JRegi/MagicAlonso-LineFollower/pcb/main_Magic_BluePIll/printable_PCB/Bluepillpinout.png

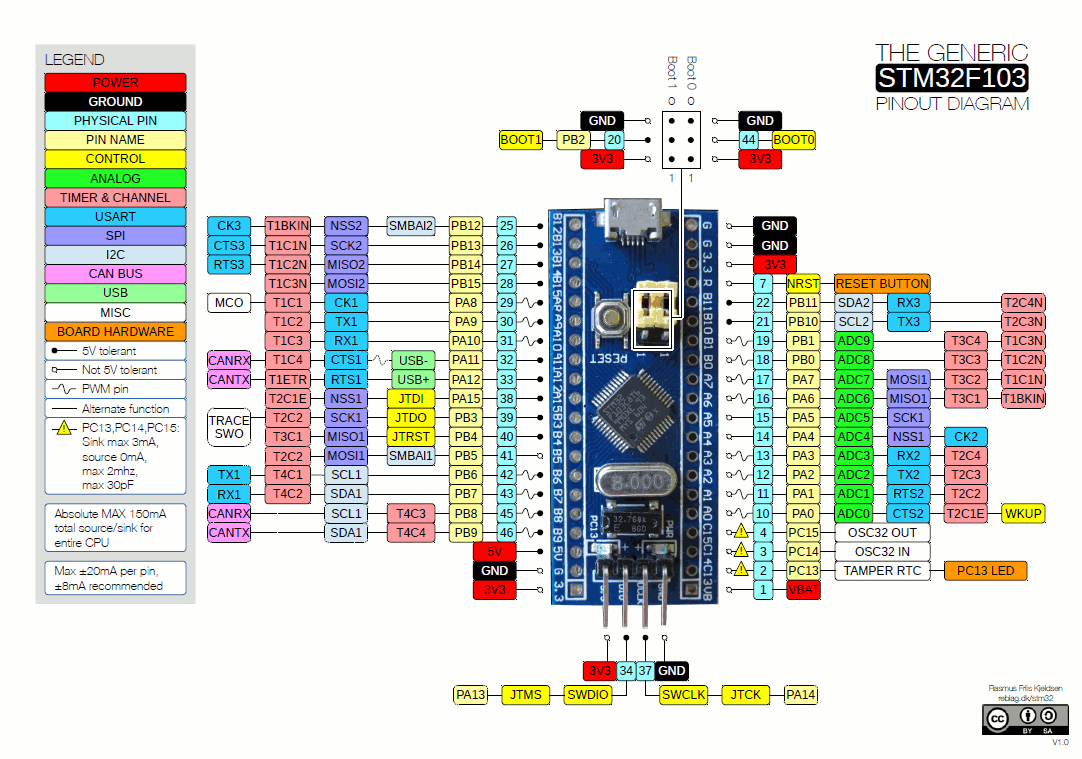
pcb/main_Magic_BluePIll/printable_PCB/Bluepillpinout.png
