JRegi/MagicAlonso-LineFollower/3D_Files/MagicAlonsoV1_ensamblado.jpg

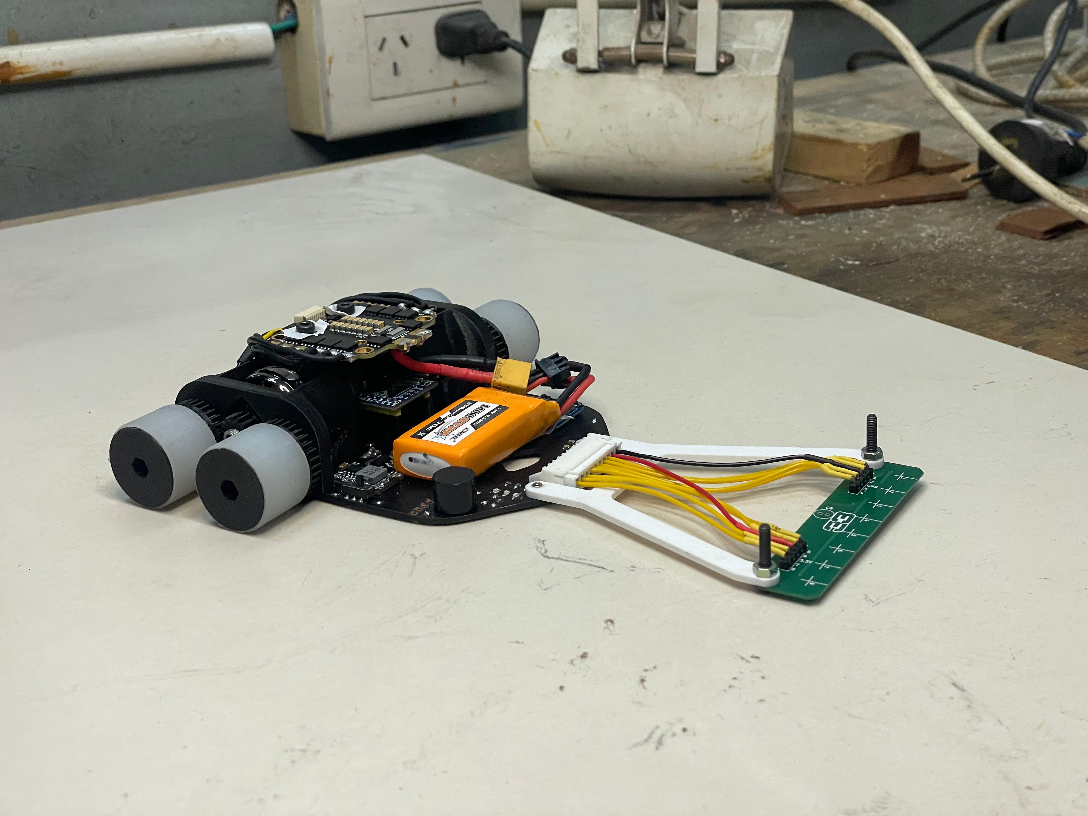
3D_Files/MagicAlonsoV1_ensamblado.jpg
