JRegi/MagicAlonso-LineFollower/README.md

# MagicAlonso - _Robot dedicado a la leyenda Asturiana del automobilismo_

## MagicAlonso V1 (sin turbina)

imagen

## Descripción

_MagicAlonso_ es un robot seguidor de líneas de alto rendimiento con tracción y succión brushless.
