JRegi/MagicAlonso-LineFollower/3D_Files/23.5mm Wheel version/Line_Sensors-Body.stl

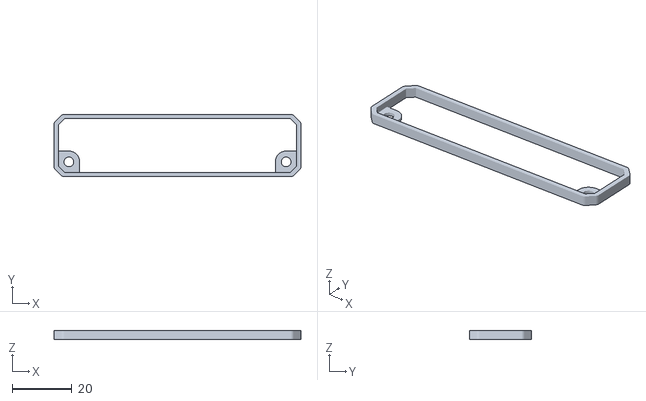
[picture p3: CAD file, 2025-08-07]
3D_Files/23.5mm Wheel version/Line_Sensors-Body.stl
83.0 x 21.0 x 3.00
