JRegi/MagicAlonso-LineFollower/3D_Files/step_files/pignon+12t+0.stp

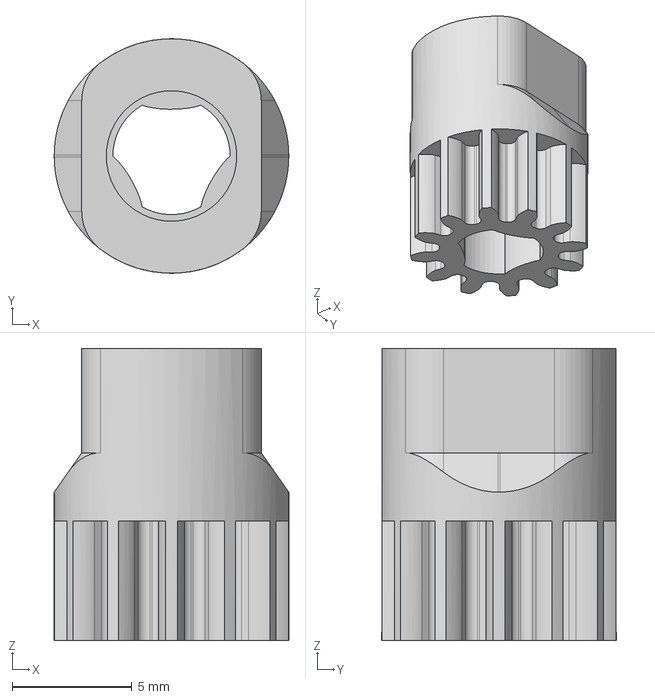
[picture p4: CAD file, 2025-07-22]
3D_Files/step_files/pignon+12t+0.stp
9.80 x 9.80 x 12.2 mm
