JRegi/MagicAlonso-LineFollower/pcb/Turbine_PCB_3P_Drawing.dxf

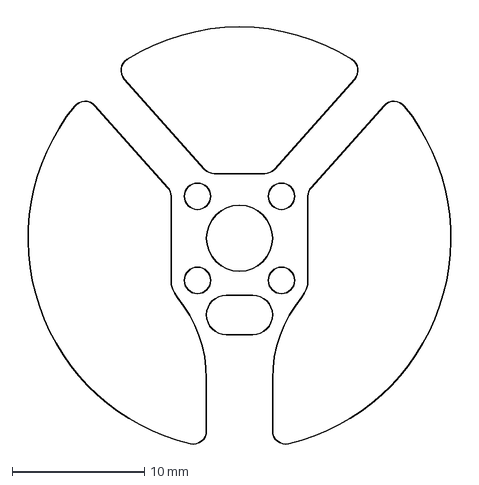
[picture p5: CAD file, 2025-08-18]
pcb/Turbine_PCB_3P_Drawing.dxf
33.8 x 32.4 mm
