JRegi/MagicAlonso-LineFollower/3D_Files/23.5mm Wheel version/Motor_mount.stl

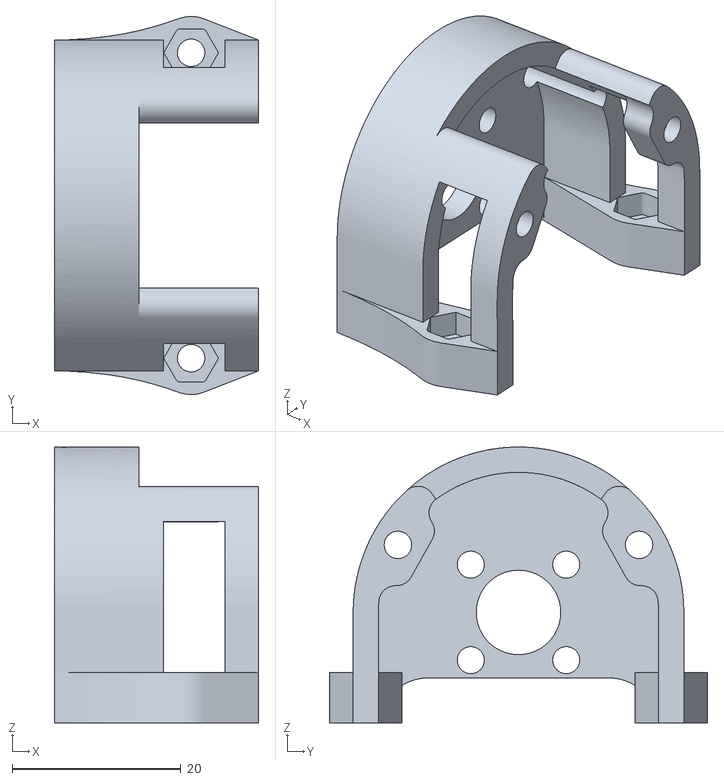
[picture p6: CAD file, 2025-07-22]
3D_Files/23.5mm Wheel version/Motor_mount.stl
24.2 x 44.8 x 32.7
