JRegi/MagicAlonso-LineFollower/3D_Files/Puente_V3.stl

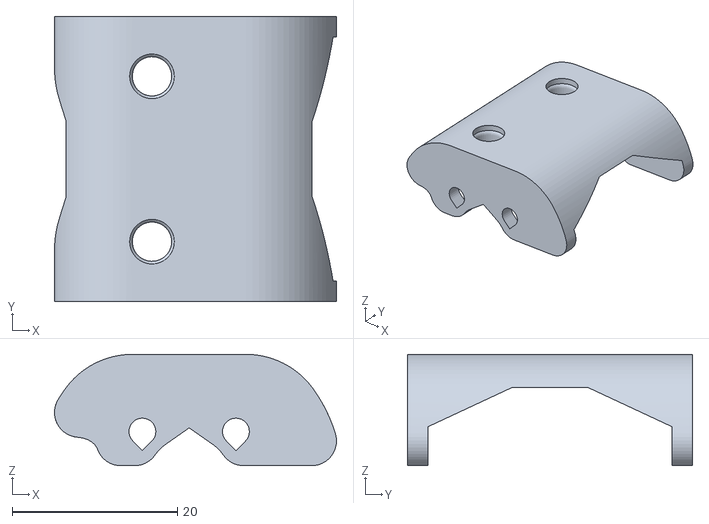
[picture p7: CAD file, 2025-09-01]
3D_Files/Puente_V3.stl
34.1 x 34.5 x 13.5
