JRegi/MagicAlonso-LineFollower/3D_Files/step_files/Molde+23.stp

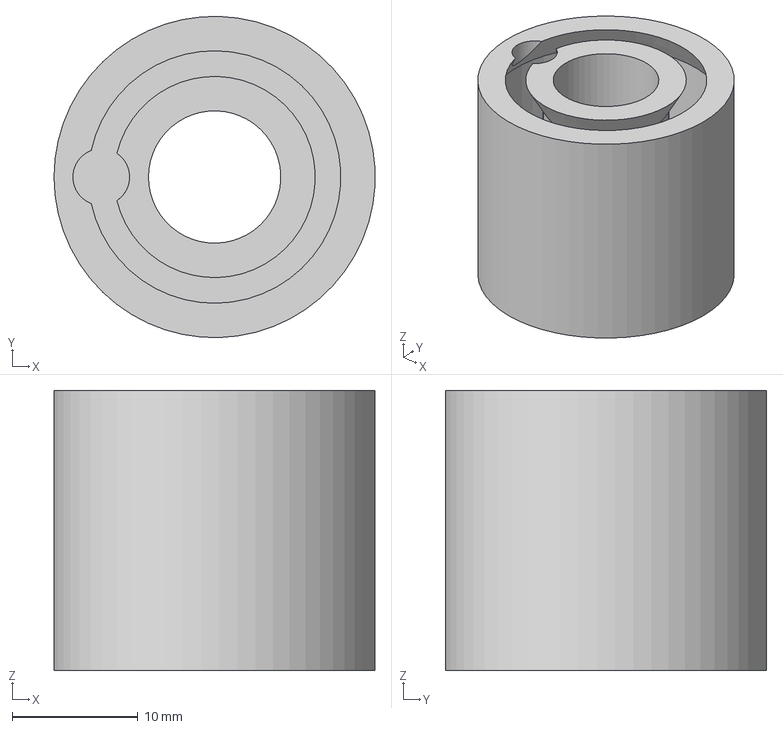
[picture p8: CAD file, 2025-07-22]
3D_Files/step_files/Molde+23.stp
25.5 x 25.5 x 22.2 mm
