JRegi/MagicAlonso-LineFollower/3D_Files/23.5mm Wheel version/23.5 Wheel 28 teeth v14.stl

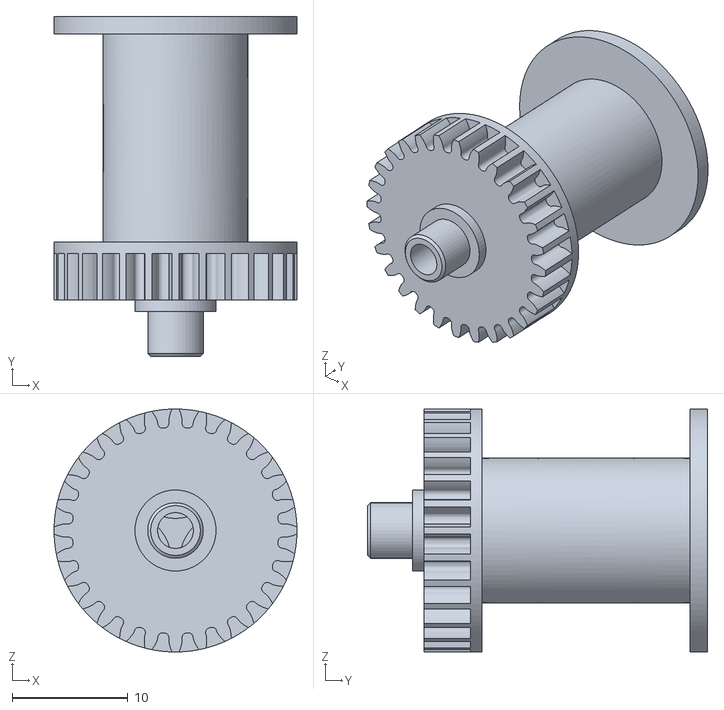
[picture p9: CAD file, 2025-06-03]
3D_Files/23.5mm Wheel version/23.5 Wheel 28 teeth v14.stl
21.0 x 29.4 x 21.0
