JRegi/MagicAlonso-LineFollower/3D_Files/Spur Gear (15 teeth).stl

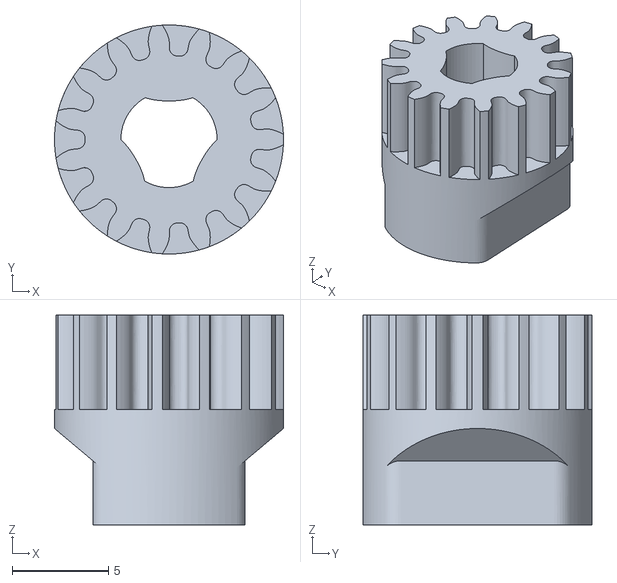
[picture p10: CAD file, 2025-09-01]
3D_Files/Spur Gear (15 teeth).stl
11.9 x 11.9 x 10.9
