JRegi/MagicAlonso-LineFollower/3D_Files/step_files/2.Redo2.9to1+23.stp

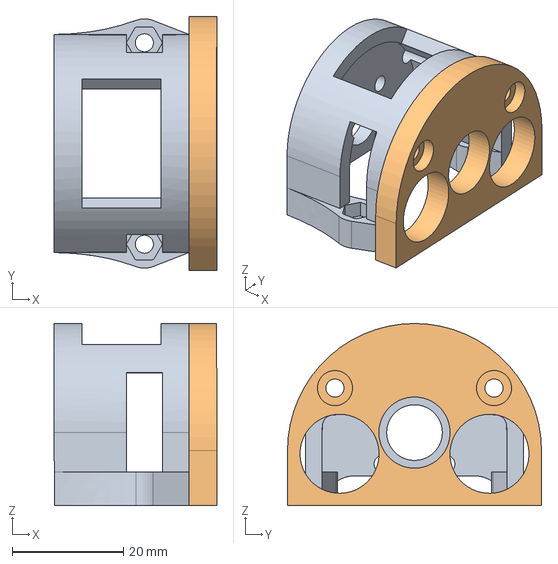
[picture p11: CAD file, 2025-07-22]
3D_Files/step_files/2.Redo2.9to1+23.stp
29.2 x 45.6 x 32.7 mm
Motor Mount
Wheel Mount
