JRegi/MagicAlonso-LineFollower/3D_Files/modulo_redu_V3.stl

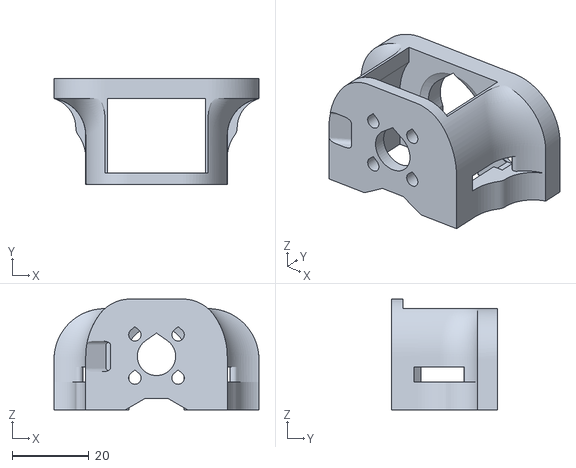
[picture p12: CAD file, 2025-09-01]
3D_Files/modulo_redu_V3.stl
53.6 x 27.8 x 29.0
