JRegi/MagicAlonso-LineFollower/3D_Files/step_files/23.stp

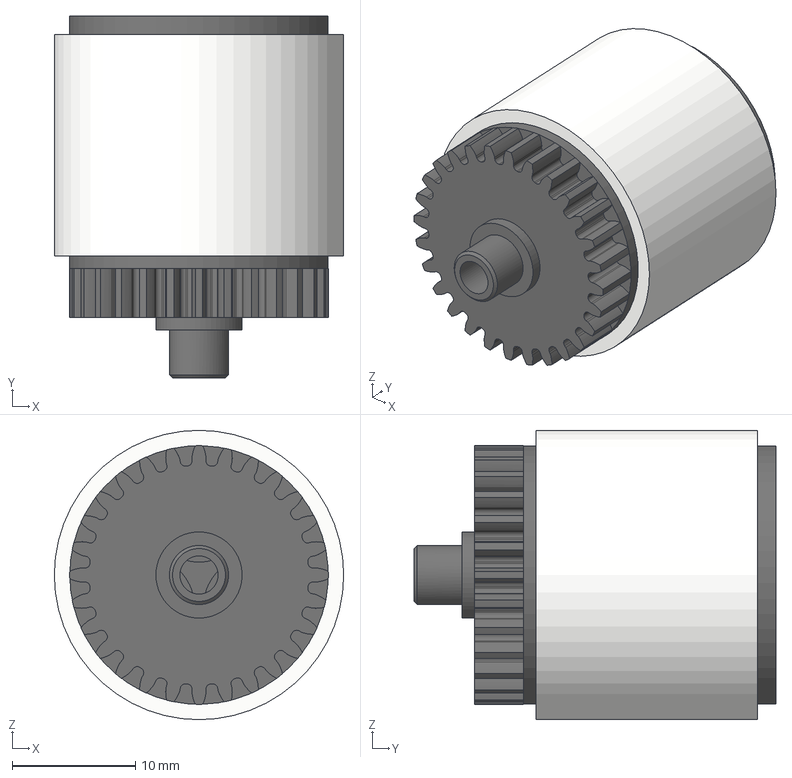
[picture p13: CAD file, 2025-07-22]
3D_Files/step_files/23.stp
23.5 x 29.4 x 23.5 mm
Rim
Spur Gear (28 teeth)
Tire
