JRegi/MagicAlonso-LineFollower/3D_Files/23.5mm Wheel version/Wheel Mount.stl

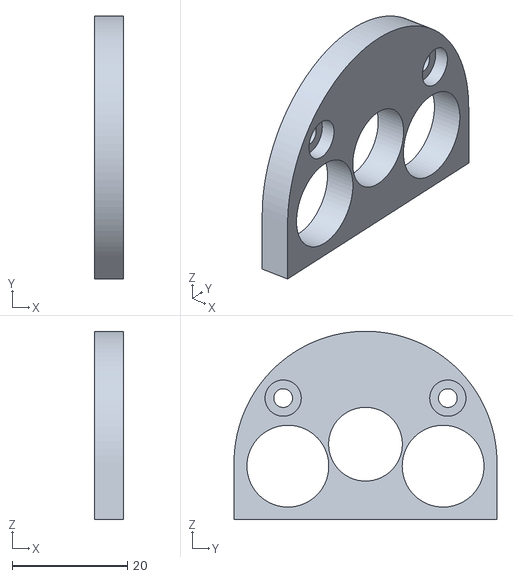
[picture p14: CAD file, 2025-06-03]
3D_Files/23.5mm Wheel version/Wheel Mount.stl
5.00 x 45.6 x 32.7
