JRegi/MagicAlonso-LineFollower/3D_Files/step_files/1.Redo2.stp

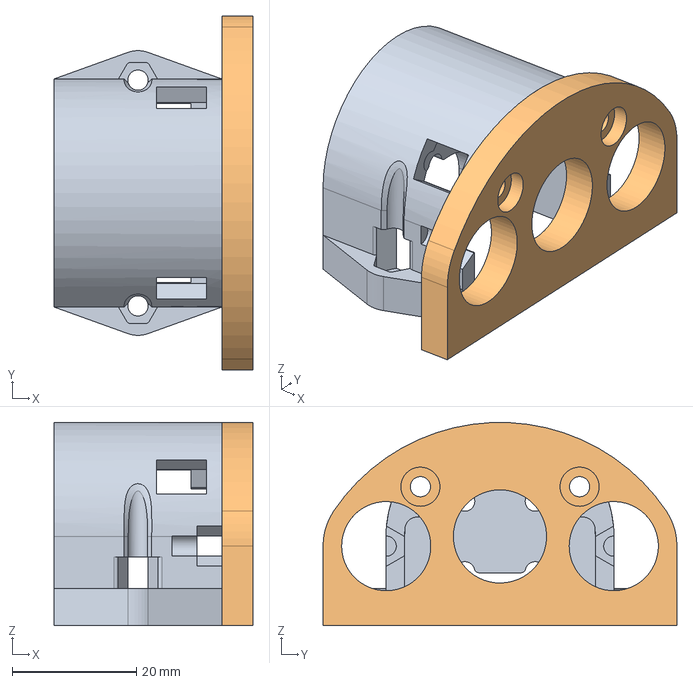
[picture p15: CAD file, 2025-07-22]
3D_Files/step_files/1.Redo2.stp
32.0 x 57.0 x 32.7 mm
Motor Mount
Wheel Mount
