JRegi/MagicAlonso-LineFollower/3D_Files/wheel_32teeth_26mm.stl

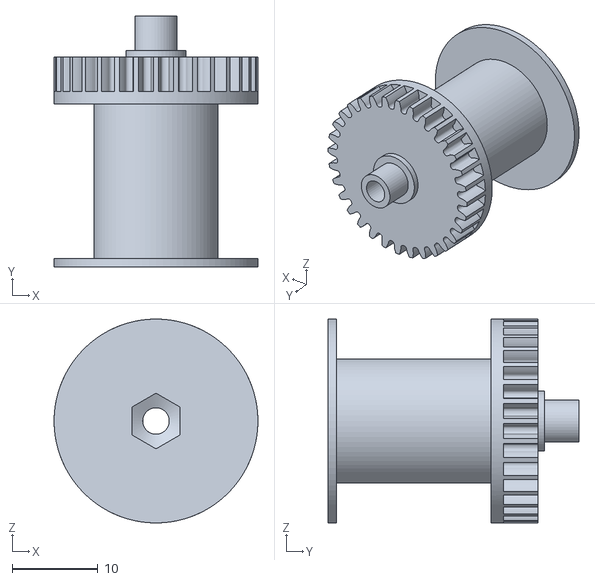
[picture p16: CAD file, 2025-09-01]
3D_Files/wheel_32teeth_26mm.stl
23.8 x 29.3 x 23.8
