JRegi/MagicAlonso-LineFollower/3D_Files/turbine_PCB_Drawing.dxf

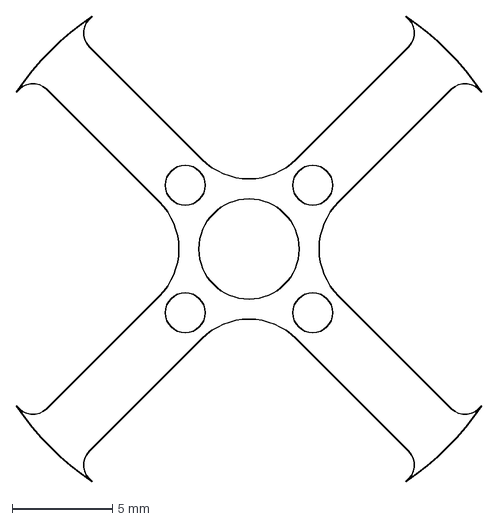
[picture p17: CAD file, 2025-08-06]
3D_Files/turbine_PCB_Drawing.dxf
23.2 x 23.2 mm
