JRegi/MagicAlonso-LineFollower/(list of files, cad)

Other CAD files:
3D_Files/1404_redu_footprint.dxf
3D_Files/23.5mm Wheel version/pignon 12t 0.7 short.stl
3D_Files/step_files/reduction.FCStd
