JRegi/MagicAlonso-LineFollower/pcb/main_Magic_BluePIll/printable_pcb.pdf

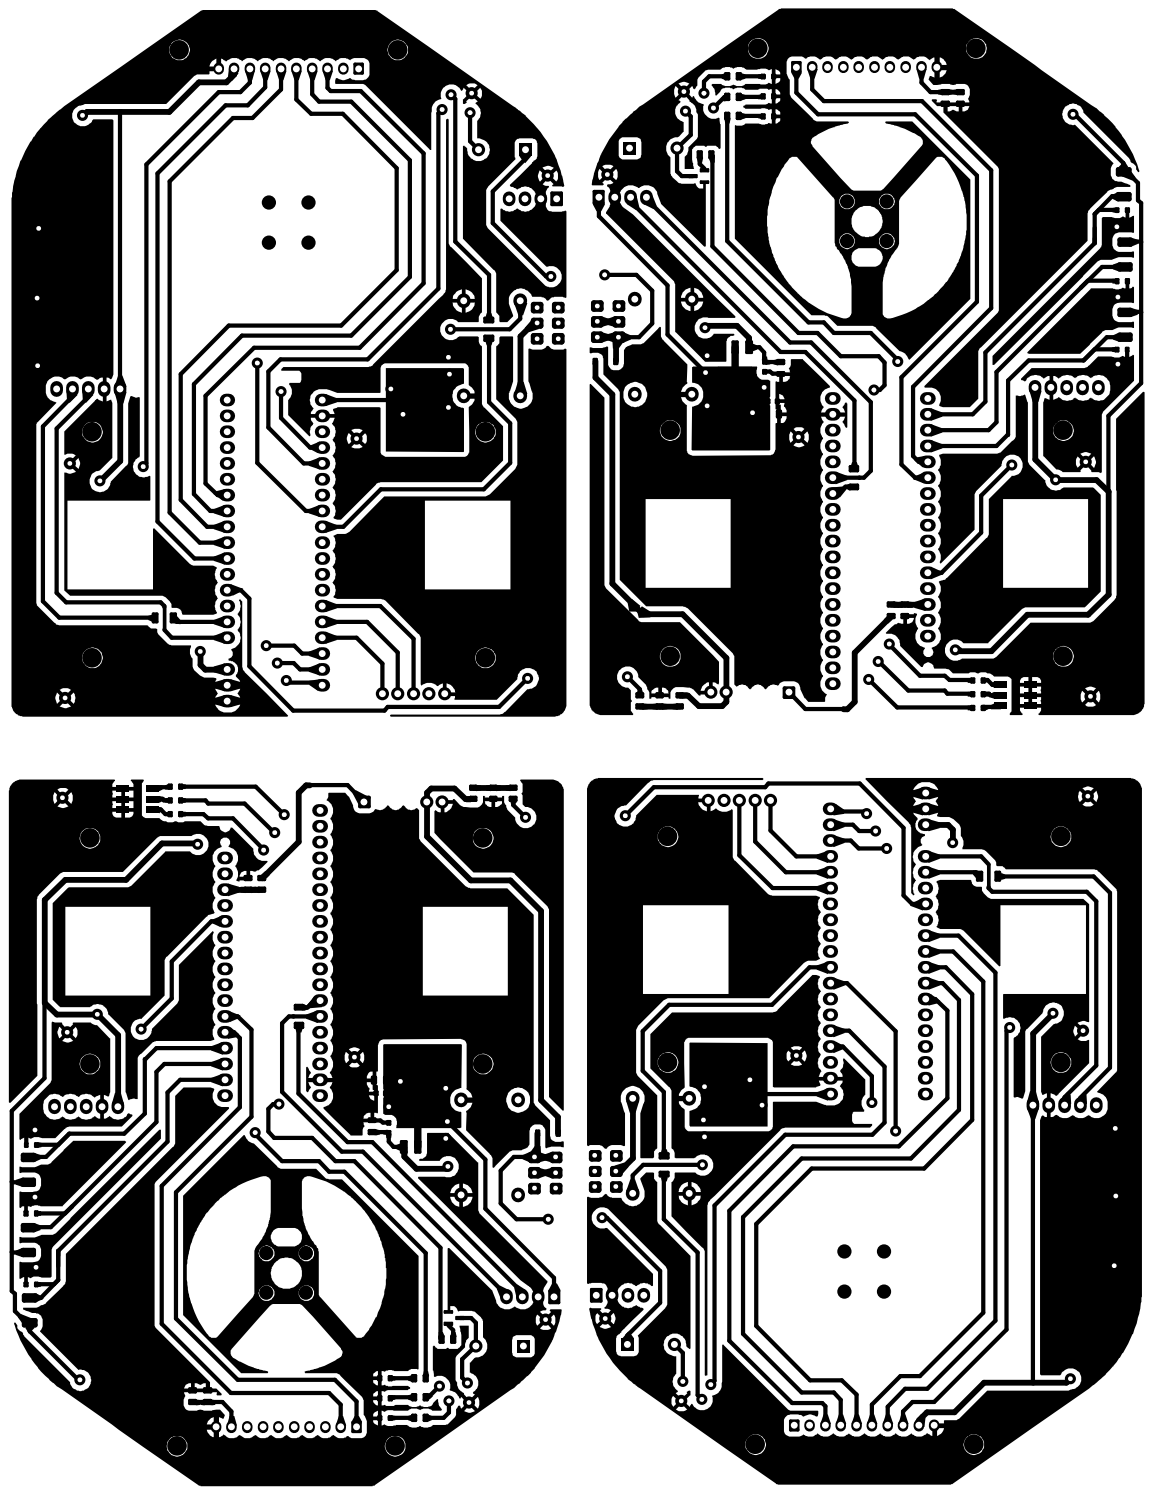
[picture p18: page 1]
