JRegi/MagicAlonso-LineFollower/pcb/ESP32_main_boards/main_Magic-simple/printable-pcb/main_Magic-simple_printable.pdf

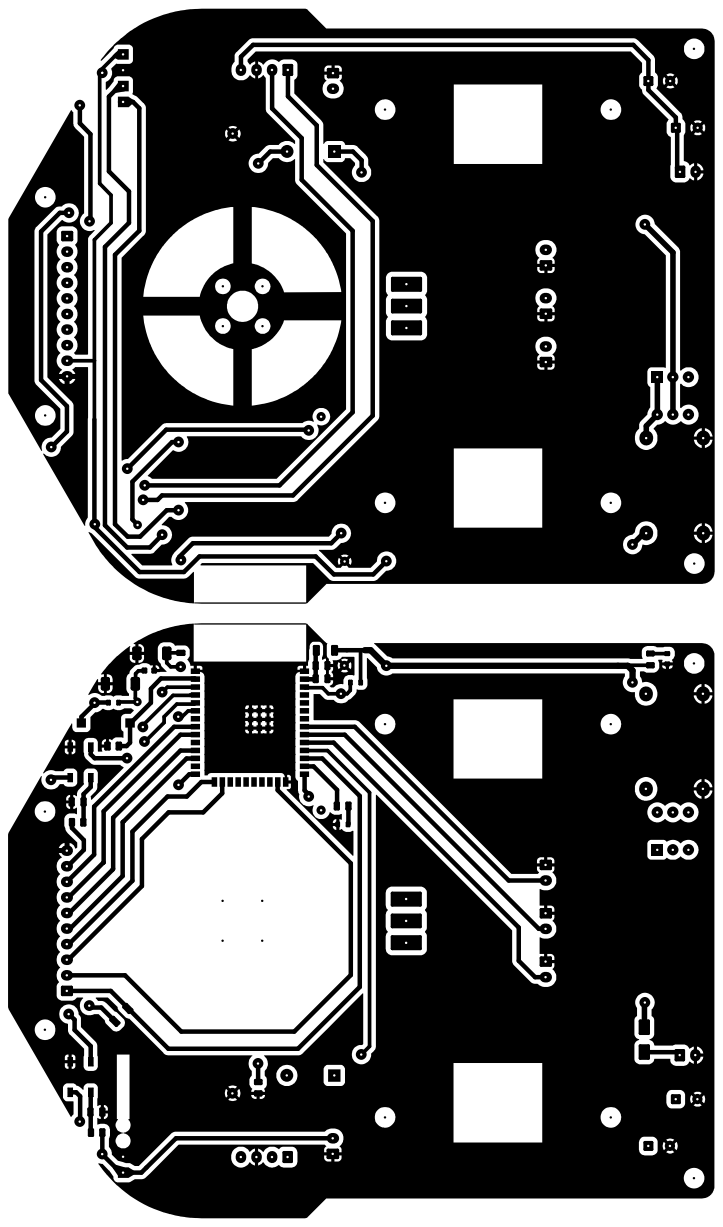
[picture p19: page 1]
