JRegi/MagicAlonso-LineFollower/pcb/main_Magic_BluePIll/main_BluePIll_1st_archive/main_Magic_BluePIll.kicad_pcb

## KiCad design pcb/main_Magic_BluePIll/main_BluePIll_1st_archive/main_Magic_BluePIll.kicad_pcb (2025-08-18, an earlier design)

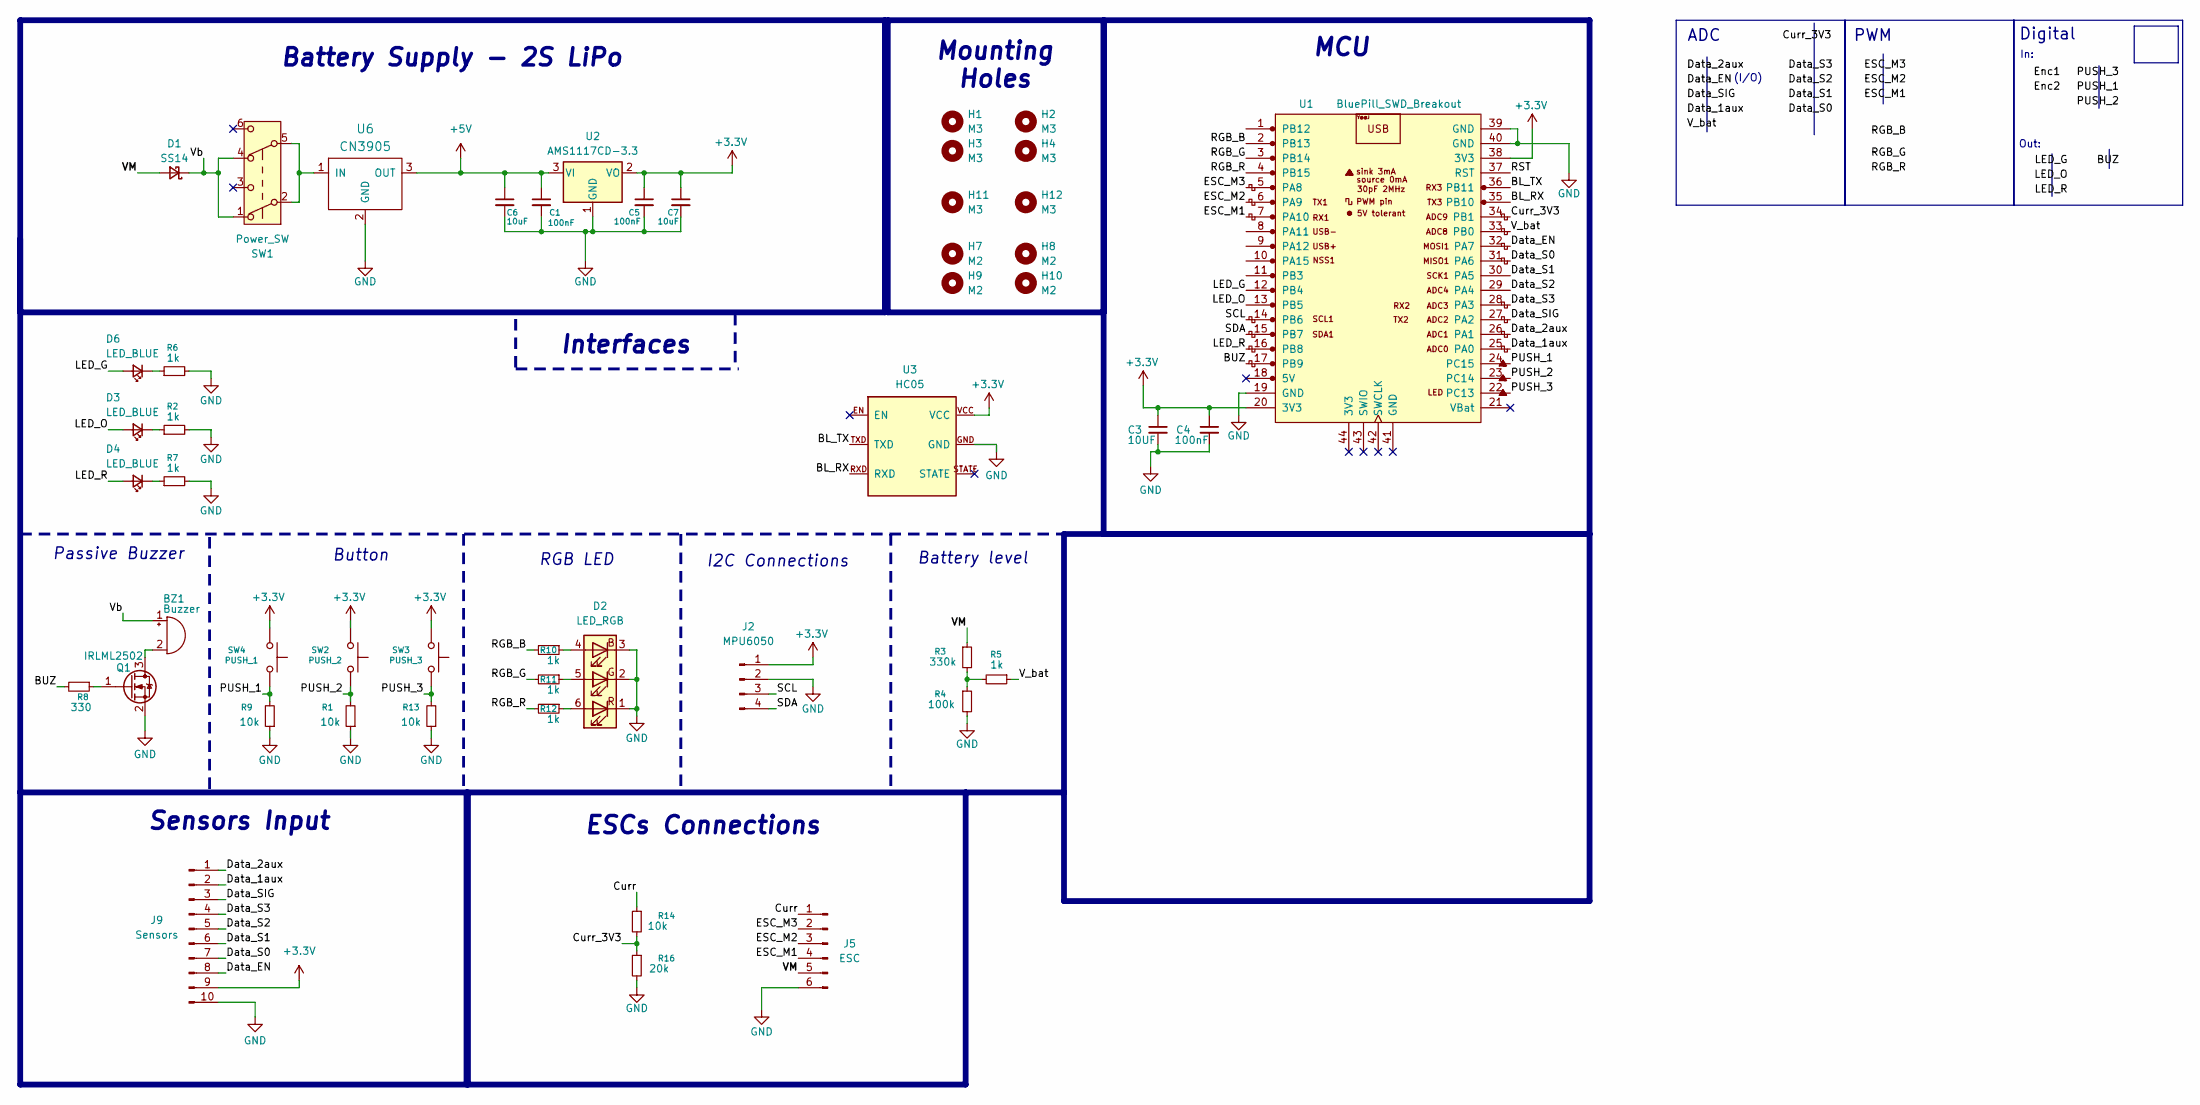
[picture p20: schematic main_Magic_BluePIll.kicad_sch, MagicAlonso main control PCB]

Parts:
BZ1: Buzzer; Buzzer_12x9.5RM7.6
C1, C5: 100nF; C_0603_1608Metric
C3: 10UF; C_0805_2012Metric
C4: 100nF; C_0805_2012Metric
C6, C7: 10uF; C_0805_2012Metric
D1: SS14; D_SOD-123
D2: LED_RGB; LED_RGB_5050-6
D3, D4, D6: LED_BLUE; LED_0805_2012Metric
H1, H2, H3, H4, H11, H12: M3; MountingHole_3mm
H7, H8, H9, H10: M2; MountingHole_2.2mm_M2
J2: MPU6050; MPU6050_Module
J5: ESC; JST_XH_B6B-XH-A_1x06_P2.50mm_Vertical
J9: Sensors; JST_XH_S10B-XH-A_1x10_P2.50mm_Horizontal
Q1: IRLML2502; SOT-23
R1, R9, R13: 10k; R_0603_1608Metric
R2, R6, R7, R10, R11, R12: 1k; R_0603_1608Metric
R3: 330k; R_0805_2012Metric
R4: 100k; R_0805_2012Metric
R5: 1k; R_0805_2012Metric
R8: 330; R_0805_2012Metric
R14: 10k; R_0805_2012Metric
R16: 20k; R_0805_2012Metric
SW1: Power_SW; SW_DPDT_SLIDE_THT
SW2: PUSH_2; SW_Push_Sw-3424p_Handsolder
SW3: PUSH_3; SW_Push_Sw-3424p_Handsolder
SW4: PUSH_1; SW_Push_Sw-3424p_Handsolder
U1: BluePill_SWD_Breakout; BluePill
U2: AMS1117CD-3.3; TO-252-3_TabPin2
U3: HC05
U6: CN3905; Mini360_step-down

Connections:
+3.3V: C3.1, C4.1, C5.1, C7.1, J2.1, J9.9, SW2.1, SW3.1, SW4.1, U1.20 (3V3), U1.38 (3V3), U2.2 (VO), U3.VCC
+5V: C1.1, C6.1, U2.3 (VI), U6.3 (OUT)
/BL_RX: U1.35 (PB10), U3.RXD
/BL_TX: U1.36 (PB11), U3.TXD
/BUZ: R8.2, U1.17 (PB9)
/Curr: J5.1, R14.1
/Curr_3V3: R14.2, R16.1, U1.34 (PB1)
/Data_1aux: J9.2, U1.25 (PA0)
/Data_2aux: J9.1, U1.26 (PA1)
/Data_EN: J9.8, U1.32 (PA7)
/Data_S0: J9.7, U1.31 (PA6)
/Data_S1: J9.6, U1.30 (PA5)
/Data_S2: J9.5, U1.29 (PA4)
/Data_S3: J9.4, U1.28 (PA3)
/Data_SIG: J9.3, U1.27 (PA2)
/ESC_M1: J5.4, U1.7 (PA10)
/ESC_M2: J5.3, U1.6 (PA9)
/ESC_M3: J5.2, U1.5 (PA8)
/LED_G: D6.2 (A), U1.12 (PB4)
/LED_O: D3.2 (A), U1.13 (PB5)
/LED_R: D4.2 (A), U1.16 (PB8)
/PUSH_1: R9.2, SW4.2, U1.24 (PC15)
/PUSH_2: R1.2, SW2.2, U1.23 (PC14)
/PUSH_3: R13.2, SW3.2, U1.22 (PC13)
/RGB_B: R10.2, U1.2 (PB13)
/RGB_G: R11.2, U1.3 (PB14)
/RGB_R: R12.2, U1.4 (PB15)
/RST: U1.37 (RST)
/SCL: J2.3, U1.14 (PB6)
/SDA: J2.4, U1.15 (PB7)
/VM: D1.2 (A), J5.5, R3.1
/V_bat: R5.1, U1.33 (PB0)
/Vb: BZ1.1 (+), D1.1 (K), SW1.1 (A), SW1.4 (A)
GND: C1.2, C3.2, C4.2, C5.2, C6.2, C7.2, D2.1 (RK), D2.2 (GK), D2.3 (BK), J2.2, J5.6, J9.10, Q1.2 (S), R1.1, R2.2, R4.2, R6.2, R7.2, R9.1, R13.1, R16.2, U1.19 (GND), U1.39 (GND), U1.40 (GND), U2.1 (GND), U3.GND, U6.2 (GND)
unnamed: BZ1.2 (-), Q1.3 (D)
unnamed: D2.4 (BA), R10.1
unnamed: D2.5 (GA), R11.1
unnamed: D2.6 (RA), R12.1
unnamed: D3.1 (K), R2.1
unnamed: D4.1 (K), R7.1
unnamed: D6.1 (K), R6.1
unnamed: Q1.1 (G), R8.1
unnamed: R3.2, R4.1, R5.2
unnamed: SW1.2 (B), SW1.5 (B), U6.1 (IN)

Notes on the sheet:
Out:
(I/O)
Passive Buzzer
Digital
Battery level
I2C Connections
Mounting Holes
Battery Supply - 2S LiPo
In:
Sensors Input
MCU
ESCs Connections
PWM
RGB LED
Button
Interfaces
ADC

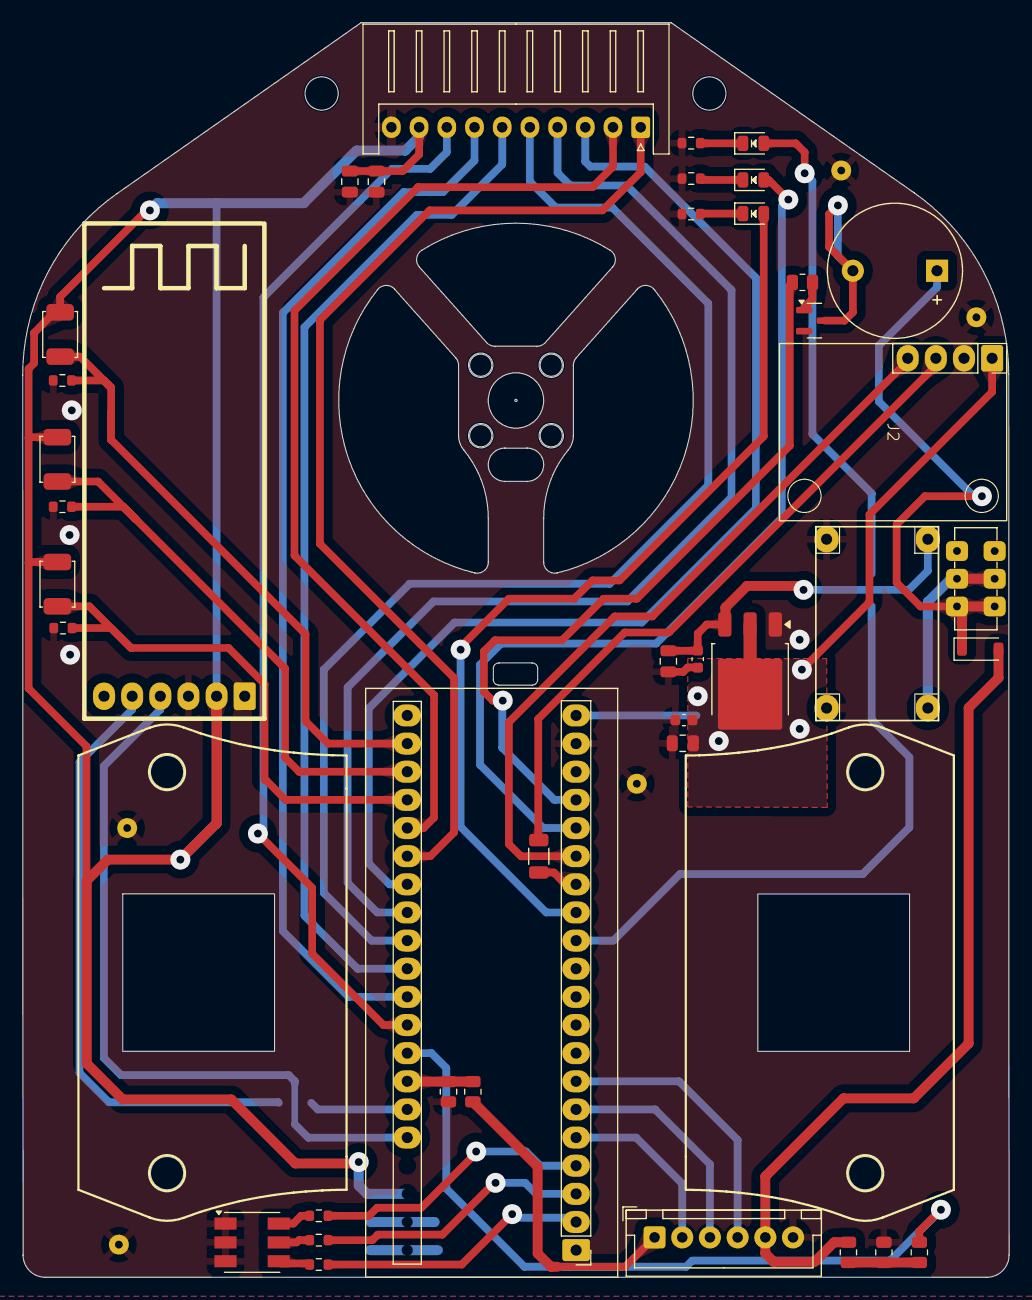
[picture p21: board main_Magic_BluePIll.kicad_pcb from above]

Board: 2 copper layers, 89.0 x 113.2 mm, 49 parts (0 on the bottom side), 43 nets.
