JRegi/MagicAlonso-LineFollower/pcb/ESP32_main_boards/main_Magic-simple/main_Magic-simple.kicad_pcb

## KiCad design pcb/ESP32_main_boards/main_Magic-simple/main_Magic-simple.kicad_pcb (2025-08-06)

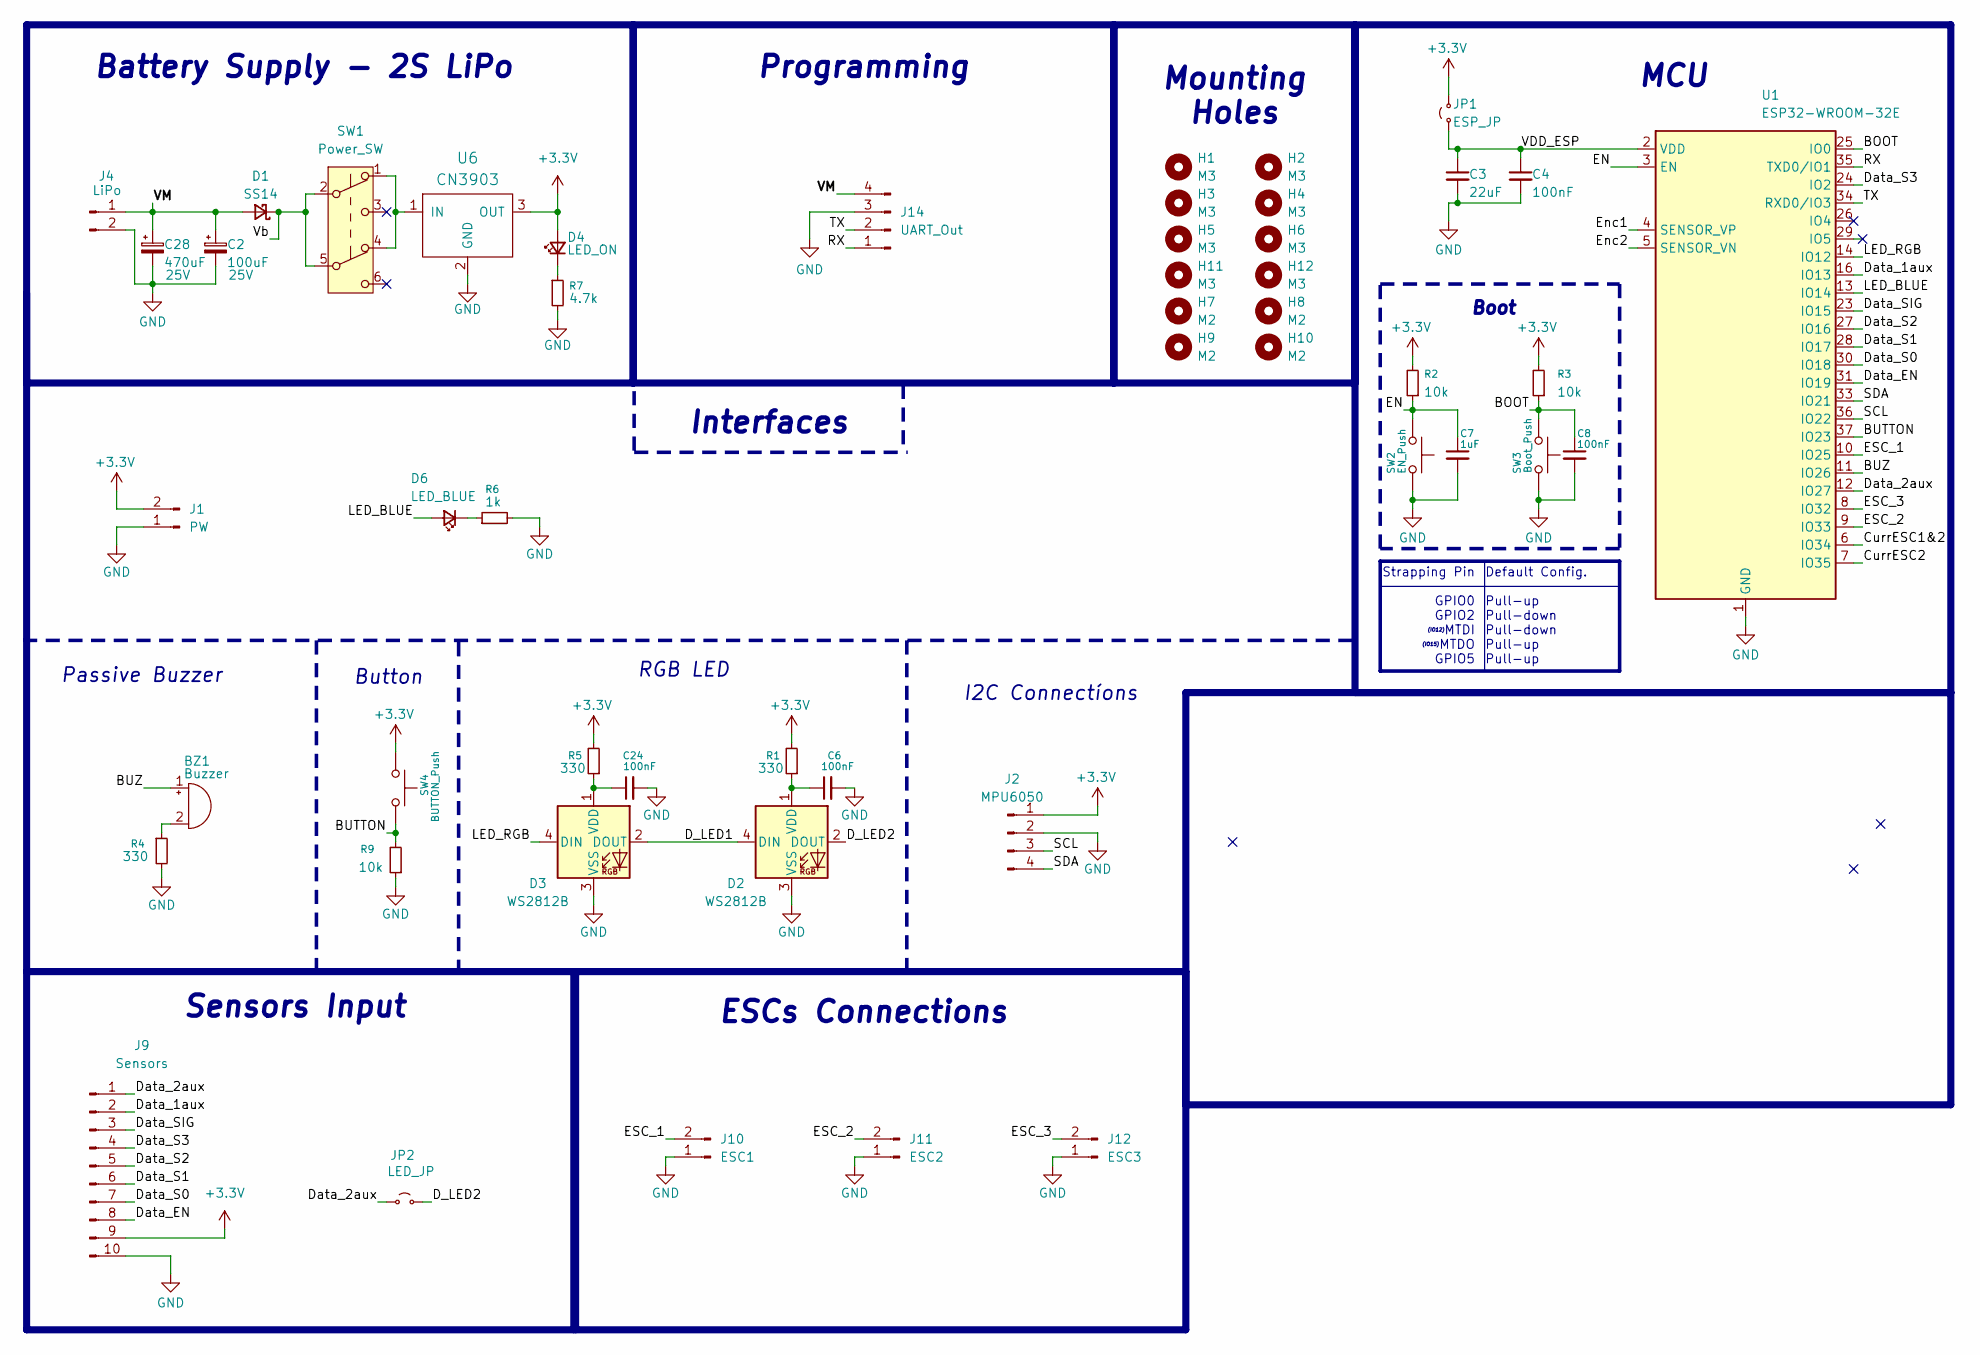
[picture p22: schematic main_Magic-simple.kicad_sch, MagicAlonso main control PCB]

Parts:
BZ1: Buzzer; Buzzer_12x9.5RM7.6
C2: 100uF; CP_Radial_D8.0mm_P3.50mm
C3: 22uF; C_0805_2012Metric
C4, C6, C24: 100nF; C_0805_2012Metric
C7: 1uF; C_0805_2012Metric
C8: 100nF; C_0603_1608Metric
C28: 470uF; CP_Radial_D8.0mm_P3.50mm
D1: SS14; D_SMA
D2, D3: WS2812B; LED_WS2812B_PLCC4_5.0x5.0mm_P3.2mm
D4: LED_ON; LED_0805_2012Metric
D6: LED_BLUE; LED_0805_2012Metric
H1, H2, H3, H4, H5, H6, H11, H12: M3; MountingHole_3mm
H7, H8, H9, H10: M2; MountingHole_2.2mm_M2
J1: PW; JST_XH_B2B-XH-A_1x02_P2.50mm_Vertical
J2: MPU6050; MPU6050_Module
J4: LiPo; JST_XH_S2B-XH-A_1x02_P2.50mm_Horizontal
J9: Sensors; JST_XH_S10B-XH-A_1x10_P2.50mm_Horizontal
J10: ESC1; JST_XH_S2B-XH-A_1x02_P2.50mm_Horizontal
J11: ESC2; JST_XH_S2B-XH-A_1x02_P2.50mm_Horizontal
J12: ESC3; JST_XH_S2B-XH-A_1x02_P2.50mm_Horizontal
J14: UART_Out; JST_XH_S4B-XH-A_1x04_P2.50mm_Horizontal
JP1: ESP_JP; R_1206_3216Metric
JP2: LED_JP; R_1206_3216Metric
R1, R4, R5: 330; R_0805_2012Metric
R2, R3: 10k; R_0603_1608Metric
R6: 1k; R_0603_1608Metric
R7: 4.7k; R_0603_1608Metric
R9: 10k; R_0805_2012Metric
SW1: Power_SW; SW_Push_2P2T_Toggle_CK_PVA2OAH5xxxxxxV2
SW2: EN_Push; SW_Push_SPST_NO_Alps_SKRK_Handsolder
SW3: Boot_Push; SW_Push_SPST_NO_Alps_SKRK_Handsolder
SW4: BUTTON_Push; SW_SPST_CK_RS282G05A3
U1: ESP32-WROOM-32E
U6: CN3903; Mini360_step-down

Connections:
+3.3V: D4.2 (A), J1.2, J2.1, J9.9, JP1.2 (B), R1.2, R2.2, R3.2, R5.2, SW4.1, U6.3 (OUT)
/BOOT: C8.1, R3.1, SW3.1, U1.25 (IO0)
/BUTTON: R9.2, SW4.2, U1.37 (IO23)
/BUZ: BZ1.1 (+), U1.11 (IO26)
/CurrESC1&2: U1.6 (IO34)
/CurrESC2: U1.7 (IO35)
/D_LED1: D2.4 (DIN), D3.2 (DOUT)
/D_LED2: D2.2 (DOUT), JP2.2 (B)
/Data_1aux: J9.2, U1.16 (IO13)
/Data_2aux: J9.1, JP2.1 (A), U1.12 (IO27)
/Data_EN: J9.8, U1.31 (IO19)
/Data_S0: J9.7, U1.30 (IO18)
/Data_S1: J9.6, U1.28 (IO17)
/Data_S2: J9.5, U1.27 (IO16)
/Data_S3: J9.4, U1.24 (IO2)
/Data_SIG: J9.3, U1.23 (IO15)
/EN: C7.1, R2.1, SW2.1, U1.3 (EN)
/ESC_1: J10.2, U1.10 (IO25)
/ESC_2: J11.2, U1.9 (IO33)
/ESC_3: J12.2, U1.8 (IO32)
/Enc1: U1.4 (SENSOR_VP)
/Enc2: U1.5 (SENSOR_VN)
/LED_BLUE: D6.2 (A), U1.13 (IO14)
/LED_RGB: D3.4 (DIN), U1.14 (IO12)
/RX: J14.1, U1.35 (TXD0/IO1)
/SCL: J2.3, U1.36 (IO22)
/SDA: J2.4, U1.33 (IO21)
/TX: J14.2, U1.34 (RXD0/IO3)
/VDD_ESP: C3.1, C4.1, JP1.1 (A), U1.2 (VDD)
/VM: C2.1, C28.1, D1.2 (A), J4.1, J14.4
/Vb: D1.1 (K), SW1.2 (B), SW1.5 (B)
GND: C2.2, C3.2, C4.2, C6.2, C7.2, C8.2, C24.2, C28.2, D2.3 (VSS), D3.3 (VSS), J1.1, J2.2, J4.2, J9.10, J10.1, J11.1, J12.1, J14.3, R4.2, R6.2, R7.2, R9.1, SW2.2, SW3.2, U1.1 (GND), U1.15 (GND), U1.38 (GND), U1.39 (GND), U6.2 (GND)
unnamed: BZ1.2 (-), R4.1
unnamed: C6.1, D2.1 (VDD), R1.1
unnamed: C24.1, D3.1 (VDD), R5.1
unnamed: D4.1 (K), R7.1
unnamed: D6.1 (K), R6.1
unnamed: SW1.1 (A), SW1.4 (A), U6.1 (IN)

Notes on the sheet:
Strapping Pin GPIO0 GPIO2 MTDI MTDO GPIO5
(IO12)
Passive Buzzer
(IO15)
I2C Connectíons
Mounting Holes
Battery Supply - 2S LiPo
Sensors Input
MCU
ESCs Connections
Boot
RGB LED
Button
Interfaces
Default Config. Pull-up Pull-down Pull-down Pull-up Pull-up
Programming

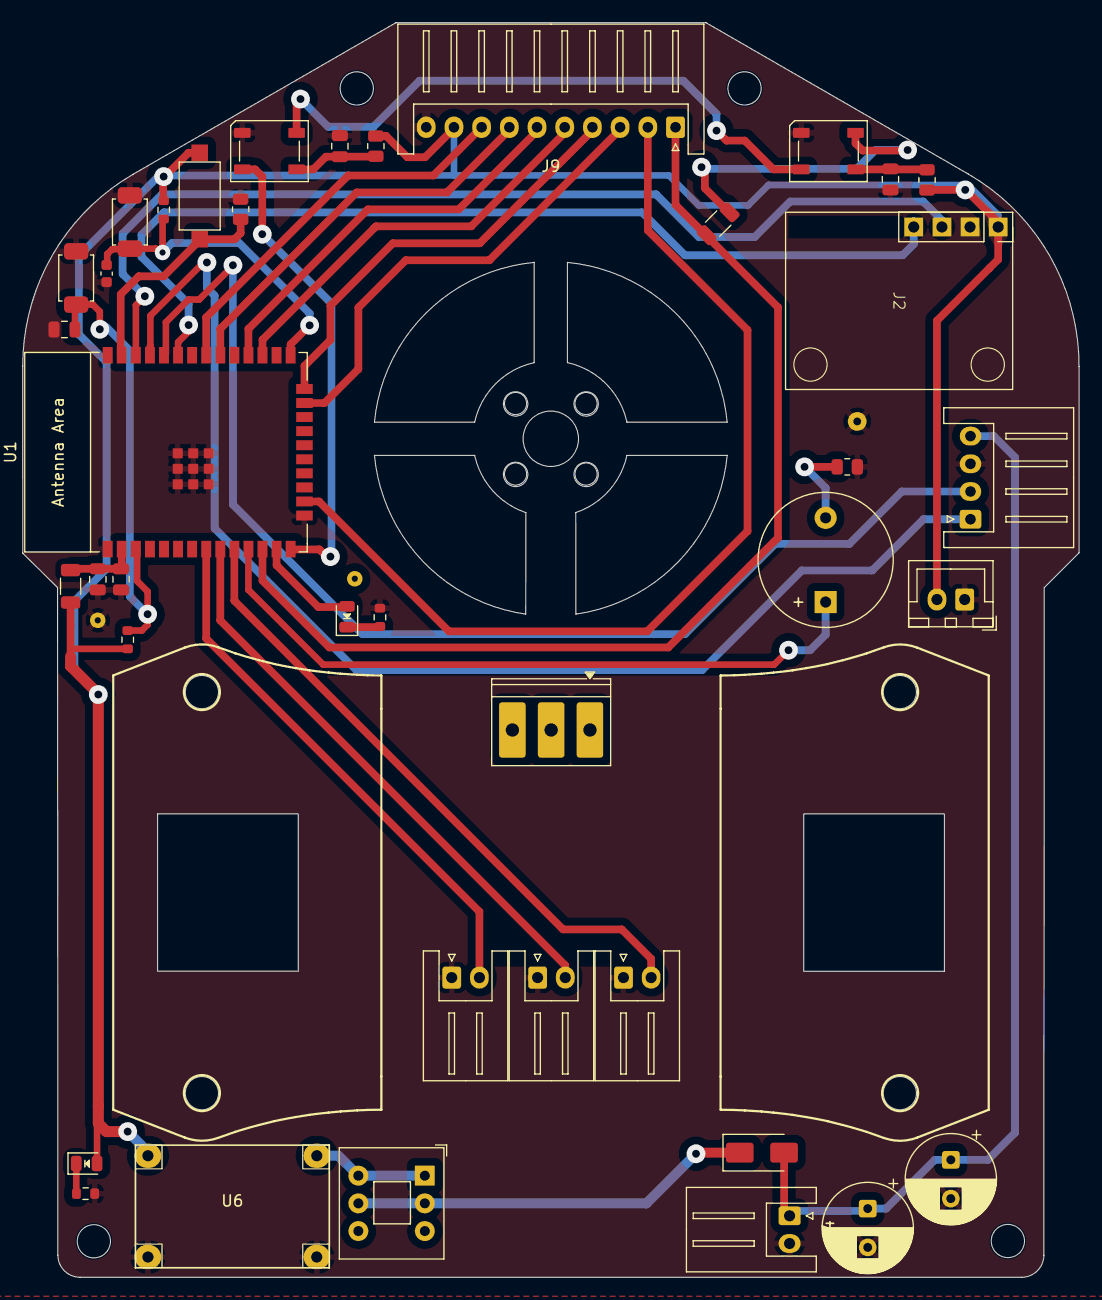
[picture p23: board main_Magic-simple.kicad_pcb from above]

Board: 2 copper layers, 95.3 x 113.2 mm, 51 parts (0 on the bottom side), 34 nets.

Other parts of the board:
ESC_3: TerminalBlock_Phoenix_PT-1,5-3-3.5-H_1x03_P3.50mm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; TerminalBlock_Phoenix_PT-1,5-3-3.5-H_1x03_P3.50mm_Horizontal
