JRegi/MagicAlonso-LineFollower/pcb/ESP32_main_boards/main_MagicAlonso/main_MagicAlonso.kicad_pcb

## KiCad design pcb/ESP32_main_boards/main_MagicAlonso/main_MagicAlonso.kicad_pcb (2025-08-06)

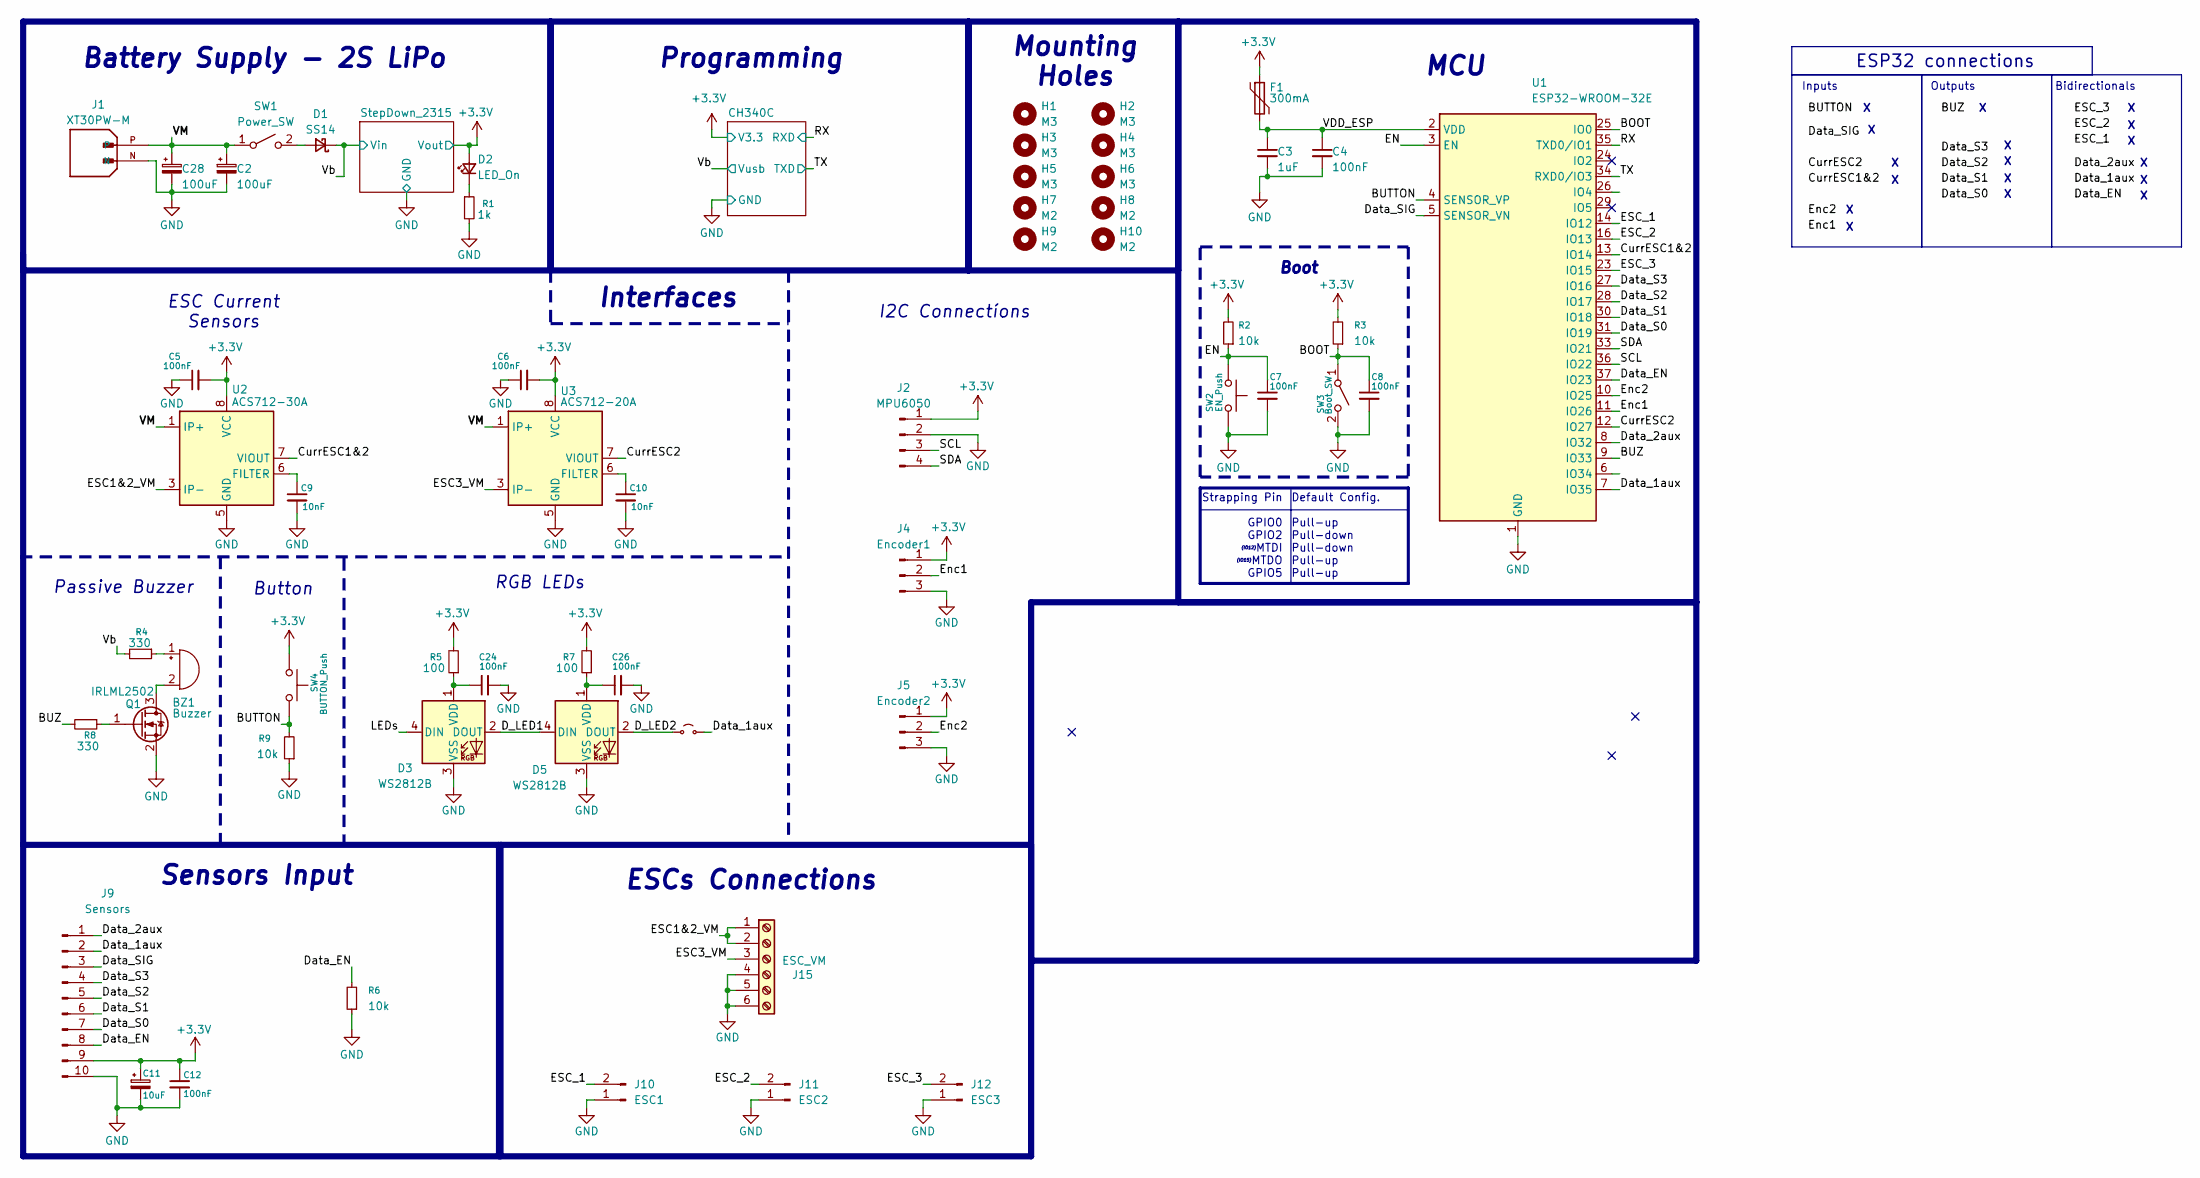
[picture p24: schematic main_MagicAlonso.kicad_sch, MagicAlonso main control PCB]

Parts:
BZ1: Buzzer; Buzzer_12x9.5RM7.6
C2, C28: 100uF; CP_Elec_6.3x5.4
C3: 1uF; C_0805_2012Metric
C4, C7, C12, C24, C26: 100nF; C_0805_2012Metric
C5, C6, C8: 100nF; C_0603_1608Metric
C9, C10: 10nF; C_0805_2012Metric
C11: 10uF; C_0805_2012Metric
D1: SS14; D_SMA
D2: LED_On; LED_0805_2012Metric
D3, D5: WS2812B; LED_WS2812B_PLCC4_5.0x5.0mm_P3.2mm
F1: 300mA; Fuse_1812_4532Metric_Pad1.30x3.40mm_HandSolder
H1, H2, H3, H4, H5, H6: M3; MountingHole_3mm
H7, H8, H9, H10: M2; MountingHole_2.2mm_M2
J1: XT30PW-M; AMASS_XT30PW-M; PARTREV 1.2
J2: MPU6050; MPU6050_Module
J4: Encoder1; JST_XH_B3B-XH-A_1x03_P2.50mm_Vertical
J5: Encoder2; JST_XH_B3B-XH-A_1x03_P2.50mm_Vertical
J9: Sensors; JST_XH_S10B-XH-A_1x10_P2.50mm_Horizontal
J10: ESC1; JST_XH_S2B-XH-A_1x02_P2.50mm_Horizontal
J11: ESC2; JST_XH_S2B-XH-A_1x02_P2.50mm_Horizontal
J12: ESC3; JST_XH_S2B-XH-A_1x02_P2.50mm_Horizontal
J15: ESC_VM; TerminalBlock_Phoenix_PT-1,5-6-3.5-H_1x06_P3.50mm_Horizontal
JP1: Jumper_2_Small_Open; R_1206_3216Metric
Q1: IRLML2502; SOT-23
R1: 1k; R_0603_1608Metric
R2, R3: 10k; R_0603_1608Metric
R4: 330; R_1206_3216Metric
R5, R7: 100; R_0805_2012Metric
R6, R9: 10k; R_0805_2012Metric
R8: 330; R_0805_2012Metric
SW1: Power_SW; SW_Slide-03_P2.54_L9_W4_H7
SW2: EN_Push; SW_SPST_CK_RS282G05A3
SW3: Boot_SW; SW_Slide-03_P2.54_L9_W4_H7
SW4: BUTTON_Push; SW_SPST_CK_RS282G05A3
U1: ESP32-WROOM-32E
U2: ACS712-30A; SOIC-8_3.9x4.9mm_P1.27mm
U3: ACS712-20A; SOIC-8_3.9x4.9mm_P1.27mm

Connections:
+3.3V: C5.2, C6.2, C11.1, C12.1, D2.2 (A), F1.1, J2.1, J4.1, J5.1, J9.9, R2.2, R3.2, R5.2, R7.2, SW4.1, U2.8 (VCC), U3.8 (VCC); also elsewhere on the board
/BOOT: C8.1, R3.1, SW3.1 (A), U1.25 (IO0)
/BUTTON: R9.2, SW4.2, U1.4 (SENSOR_VP)
/BUZ: R8.2, U1.9 (IO33)
/CurrESC1&2: U1.13 (IO14), U2.7 (VIOUT)
/CurrESC2: U1.12 (IO27), U3.7 (VIOUT)
/D_LED1: D3.2 (DOUT), D5.4 (DIN)
/D_LED2: D5.2 (DOUT), JP1.1 (A)
/Data_1aux: J9.2, JP1.2 (B), U1.7 (IO35)
/Data_2aux: J9.1, U1.8 (IO32)
/Data_EN: J9.8, R6.2, U1.37 (IO23)
/Data_S0: J9.7, U1.31 (IO19)
/Data_S1: J9.6, U1.30 (IO18)
/Data_S2: J9.5, U1.28 (IO17)
/Data_S3: J9.4, U1.27 (IO16)
/Data_SIG: J9.3, U1.5 (SENSOR_VN)
/EN: C7.1, R2.1, SW2.1, U1.3 (EN)
/ESC1&2_VM: J15.1, J15.2, U2.3 (IP-), U2.4 (IP-)
/ESC3_VM: J15.3, U3.3 (IP-), U3.4 (IP-)
/ESC_1: J10.2, U1.14 (IO12)
/ESC_2: J11.2, U1.16 (IO13)
/ESC_3: J12.2, U1.23 (IO15)
/Enc1: J4.2, U1.11 (IO26)
/Enc2: J5.2, U1.10 (IO25)
/LEDs: D3.4 (DIN)
/RX: U1.35 (TXD0/IO1); also elsewhere on the board
/SCL: J2.3, U1.36 (IO22)
/SDA: J2.4, U1.33 (IO21)
/TX: U1.34 (RXD0/IO3); also elsewhere on the board
/VDD_ESP: C3.1, C4.1, F1.2, U1.2 (VDD)
/VM: C2.1, C28.1, J1.P, SW1.1 (A), U2.1 (IP+), U2.2 (IP+), U3.1 (IP+), U3.2 (IP+)
/Vb: D1.1 (K), R4.2; also elsewhere on the board
GND: C2.2, C3.2, C4.2, C5.1, C6.1, C7.2, C8.2, C9.2, C10.2, C11.2, C12.2, C24.2, C26.2, C28.2, D3.3 (VSS), D5.3 (VSS), J1.N, J2.2, J4.3, J5.3, J9.10, J10.1, J11.1, J12.1, J15.4, J15.5, J15.6, Q1.2 (S), R1.2, R6.1, R9.1, SW2.2, SW3.2 (B), U1.1 (GND), U1.15 (GND), U1.38 (GND), U1.39 (GND), U2.5 (GND), U3.5 (GND); also elsewhere on the board
unnamed: BZ1.1 (+), R4.1
unnamed: BZ1.2 (-), Q1.3 (D)
unnamed: D1.2 (A), SW1.2 (B)
unnamed: D2.1 (K), R1.1
unnamed: C24.1, D3.1 (VDD), R5.1
unnamed: C26.1, D5.1 (VDD), R7.1
unnamed: Q1.1 (G), R8.1
unnamed: C9.1, U2.6 (FILTER)
unnamed: C10.1, U3.6 (FILTER)

Notes on the sheet:
ESC Current Sensors
Strapping Pin GPIO0 GPIO2 MTDI MTDO GPIO5
Inputs
(IO12)
Passive Buzzer
(IO15)
I2C Connectíons
Mounting Holes
ESP32 connections
Battery Supply - 2S LiPo
Sensors Input
MCU
ESCs Connections
Boot
RGB LEDs
Outputs
Button
Interfaces
Bidirectionals
Default Config. Pull-up Pull-down Pull-down Pull-up Pull-up
Programming

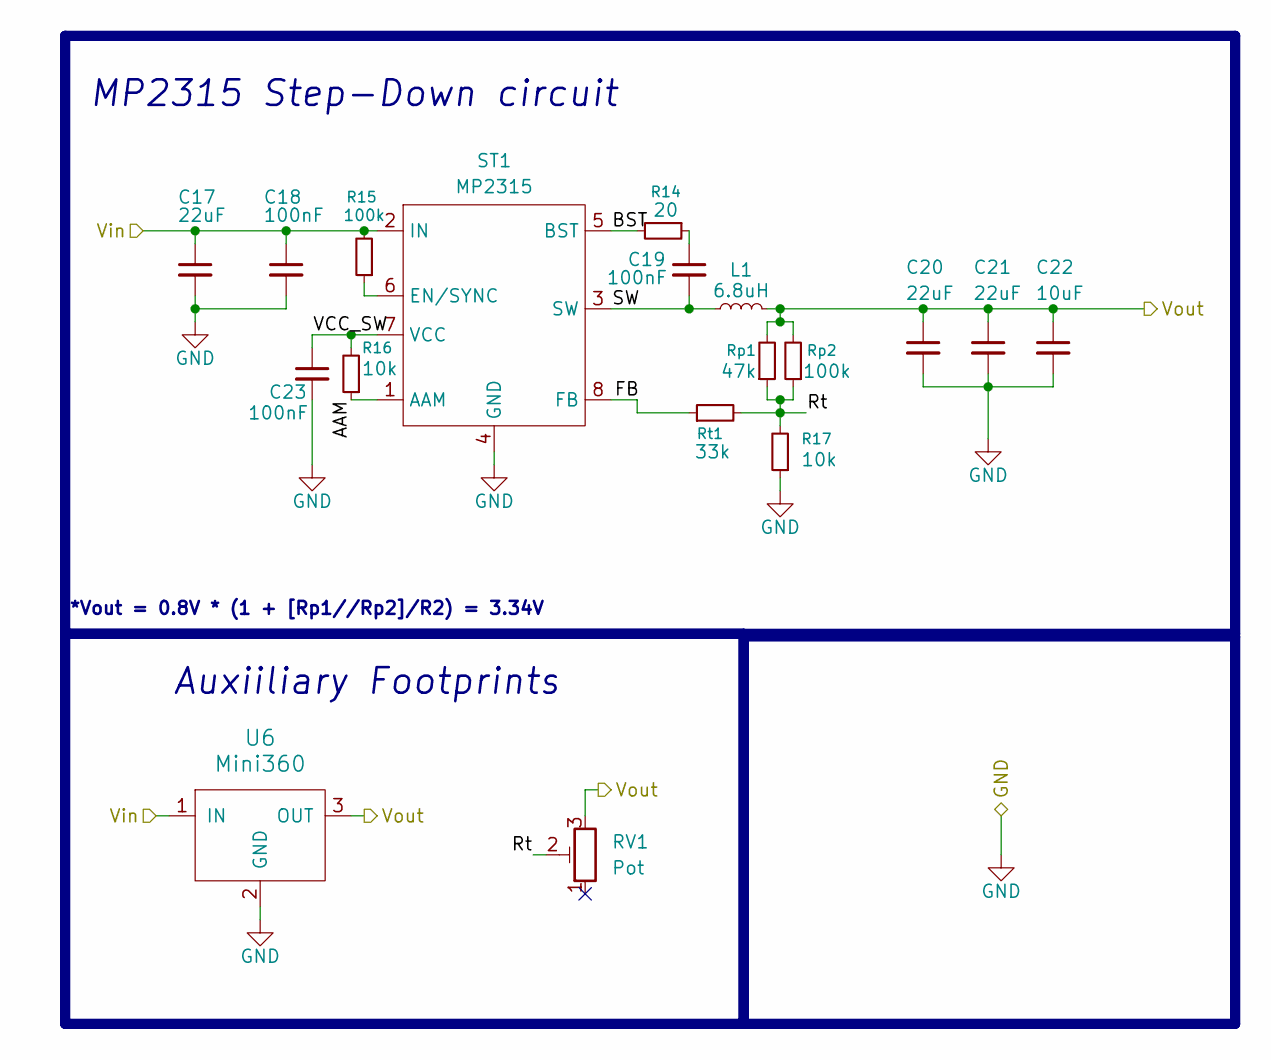
[picture p25: schematic StepDown_2315.kicad_sch]

Parts:
C17, C20, C21: 22uF; C_0805_2012Metric
C18, C19, C23: 100nF; C_0603_1608Metric
C22: 10uF; C_0805_2012Metric
L1: 6.8uH; L_TDK_SLF6025
R14: 20; R_0805_2012Metric
R15: 100k; R_0603_1608Metric
R16: 10k; R_0603_1608Metric
R17: 10k; R_0805_2012Metric
RV1: Pot; Potentiometer_Vishay_TS53YJ_Vertical
Rp1: 47k; R_0805_2012Metric
Rp2: 100k; R_0805_2012Metric
Rt1: 33k; R_0603_1608Metric
ST1: MP2315; TSOT-23-8
U6: Mini360; Mini360_step-down

Connections:
+3.3V: C20.1, C21.1, C22.1, L1.2, RV1.3, Rp1.2, Rp2.2, U6.3 (OUT); also elsewhere on the board
/StepDown_2315/AAM: R16.1, ST1.1 (AAM)
/StepDown_2315/BST: R14.2, ST1.5 (BST)
/StepDown_2315/FB: Rt1.1, ST1.8 (FB)
/StepDown_2315/Rt: R17.2, RV1.2, Rp1.1, Rp2.1, Rt1.2
/StepDown_2315/SW: C19.2, L1.1, ST1.3 (SW)
/StepDown_2315/VCC_SW: C23.1, R16.2, ST1.7 (VCC)
/Vb: C17.1, C18.1, R15.2, ST1.2 (IN), U6.1 (IN); also elsewhere on the board
GND: C17.2, C18.2, C20.2, C21.2, C22.2, C23.2, R17.1, ST1.4 (GND), U6.2 (GND); also elsewhere on the board
unnamed: C19.1, R14.1
unnamed: R15.1, ST1.6 (EN/SYNC)

Notes on the sheet:
*Vout = 0.8V * (1 + [Rp1//Rp2]/R2) = 3.34V
Auxiiliary Footprints
MP2315 Step-Down circuit

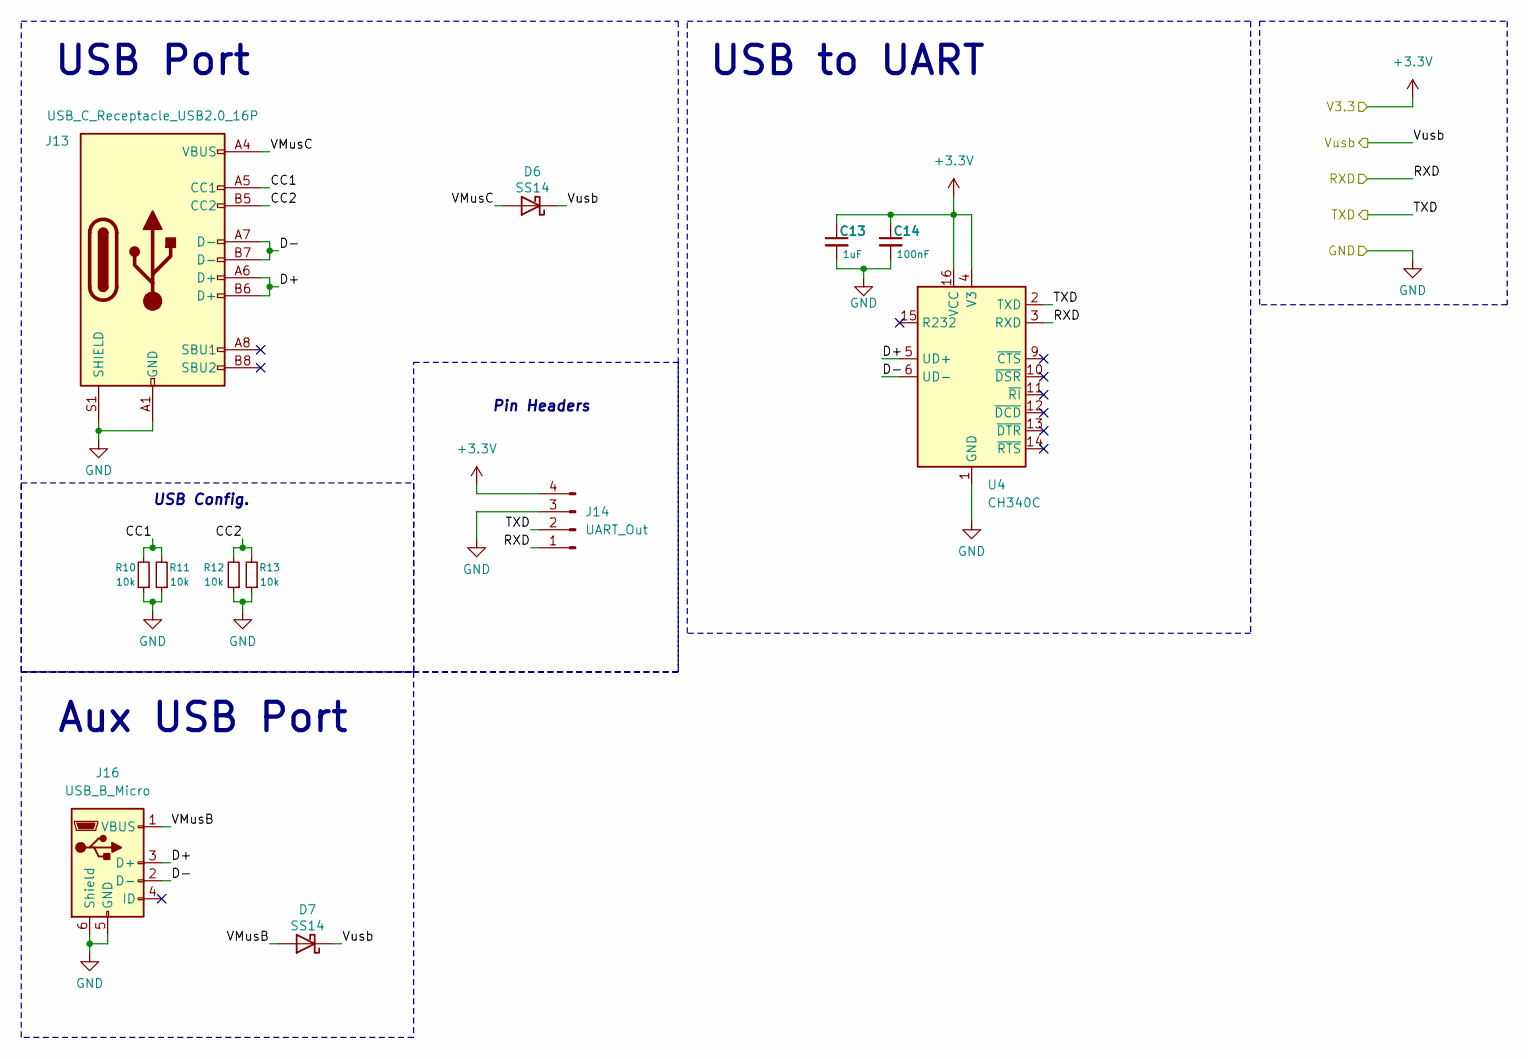
[picture p26: schematic CH340G_programmer.kicad_sch]

Parts:
C13: 1uF; C_0805_2012Metric
C14: 100nF; C_0603_1608Metric
D6, D7: SS14; D_SMA
J13: USB_C_Receptacle_USB2.0_16P; USB_C_Receptacle_GCT_USB4110
J14: UART_Out; JST_XH_S4B-XH-A_1x04_P2.50mm_Horizontal
J16: USB_B_Micro; USB_Micro-B_Amphenol_10104110_Horizontal
R10, R11, R12, R13: 10k; R_0603_1608Metric
U4: CH340C; SOIC-16_3.9x9.9mm_P1.27mm

Connections:
+3.3V: C13.1, C14.1, J14.4, U4.4 (V3), U4.16 (VCC); also elsewhere on the board
/CH340C/CC1: J13.A5 (CC1), R10.2, R11.2
/CH340C/CC2: J13.B5 (CC2), R12.2, R13.2
/CH340C/D+: J13.A6 (D+), J13.B6 (D+), J16.3 (D+), U4.5 (UD+)
/CH340C/D-: J13.A7 (D-), J13.B7 (D-), J16.2 (D-), U4.6 (UD-)
/CH340C/VMusB: D7.2 (A), J16.1 (VBUS)
/CH340C/VMusC: D6.2 (A), J13.A4 (VBUS), J13.A9 (VBUS), J13.B4 (VBUS), J13.B9 (VBUS)
/RX: J14.1, U4.3 (RXD); also elsewhere on the board
/TX: J14.2, U4.2 (TXD); also elsewhere on the board
/Vb: D6.1 (K), D7.1 (K); also elsewhere on the board
GND: C13.2, C14.2, J13.A1 (GND), J13.A12 (GND), J13.B1 (GND), J13.B12 (GND), J13.S1 (SHIELD), J14.3, J16.5 (GND), J16.6 (Shield), R10.1, R11.1, R12.1, R13.1, U4.1 (GND); also elsewhere on the board

Notes on the sheet:
USB to UART
Pin Headers
USB Config.
USB Port
Aux USB Port
