JRegi/MagicAlonso-LineFollower/pcb/ESP32_main_boards/main_MagicAlonso/main_MagicAlonso.kicad_pcb

## KiCad design pcb/ESP32_main_boards/main_MagicAlonso/main_MagicAlonso.kicad_pcb (continued)

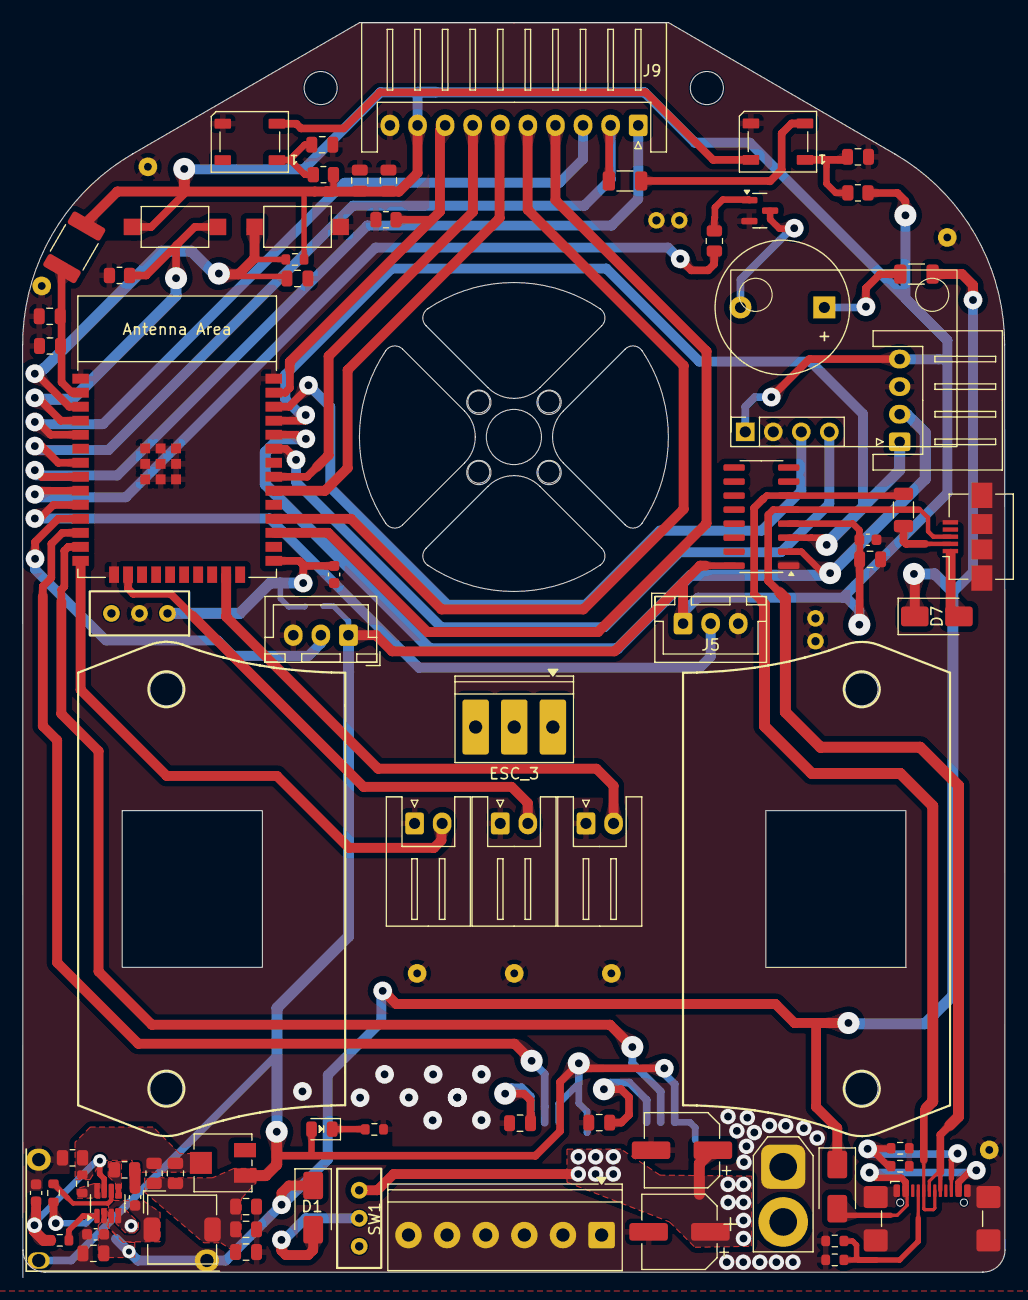
[picture p27: board main_MagicAlonso.kicad_pcb from above]

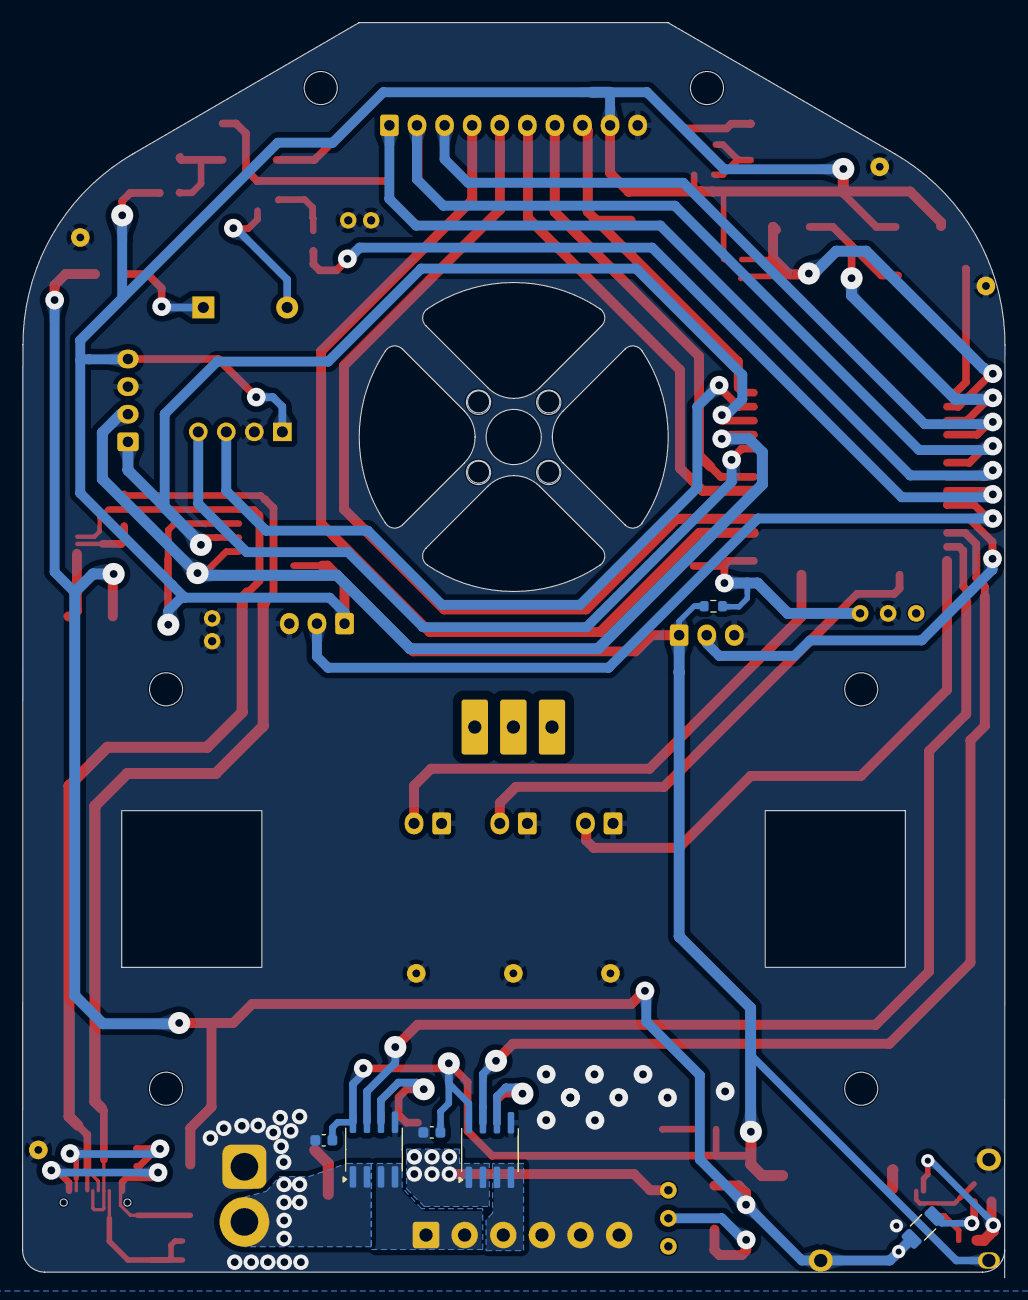
[picture p28: board main_MagicAlonso.kicad_pcb from below]

Board: 2 copper layers, 89.0 x 113.2 mm, 88 parts (5 on the bottom side), 55 nets.

Other parts of the board:
ESC_3: TerminalBlock_Phoenix_PT-1,5-3-3.5-H_1x03_P3.50mm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; TerminalBlock_Phoenix_PT-1,5-3-3.5-H_1x03_P3.50mm_Horizontal
