JRegi/MagicAlonso-LineFollower/pcb/sensors16_MagicAlonso/sensors16_MagicAlonso.kicad_pcb

## KiCad design pcb/sensors16_MagicAlonso/sensors16_MagicAlonso.kicad_pcb (2025-08-06)

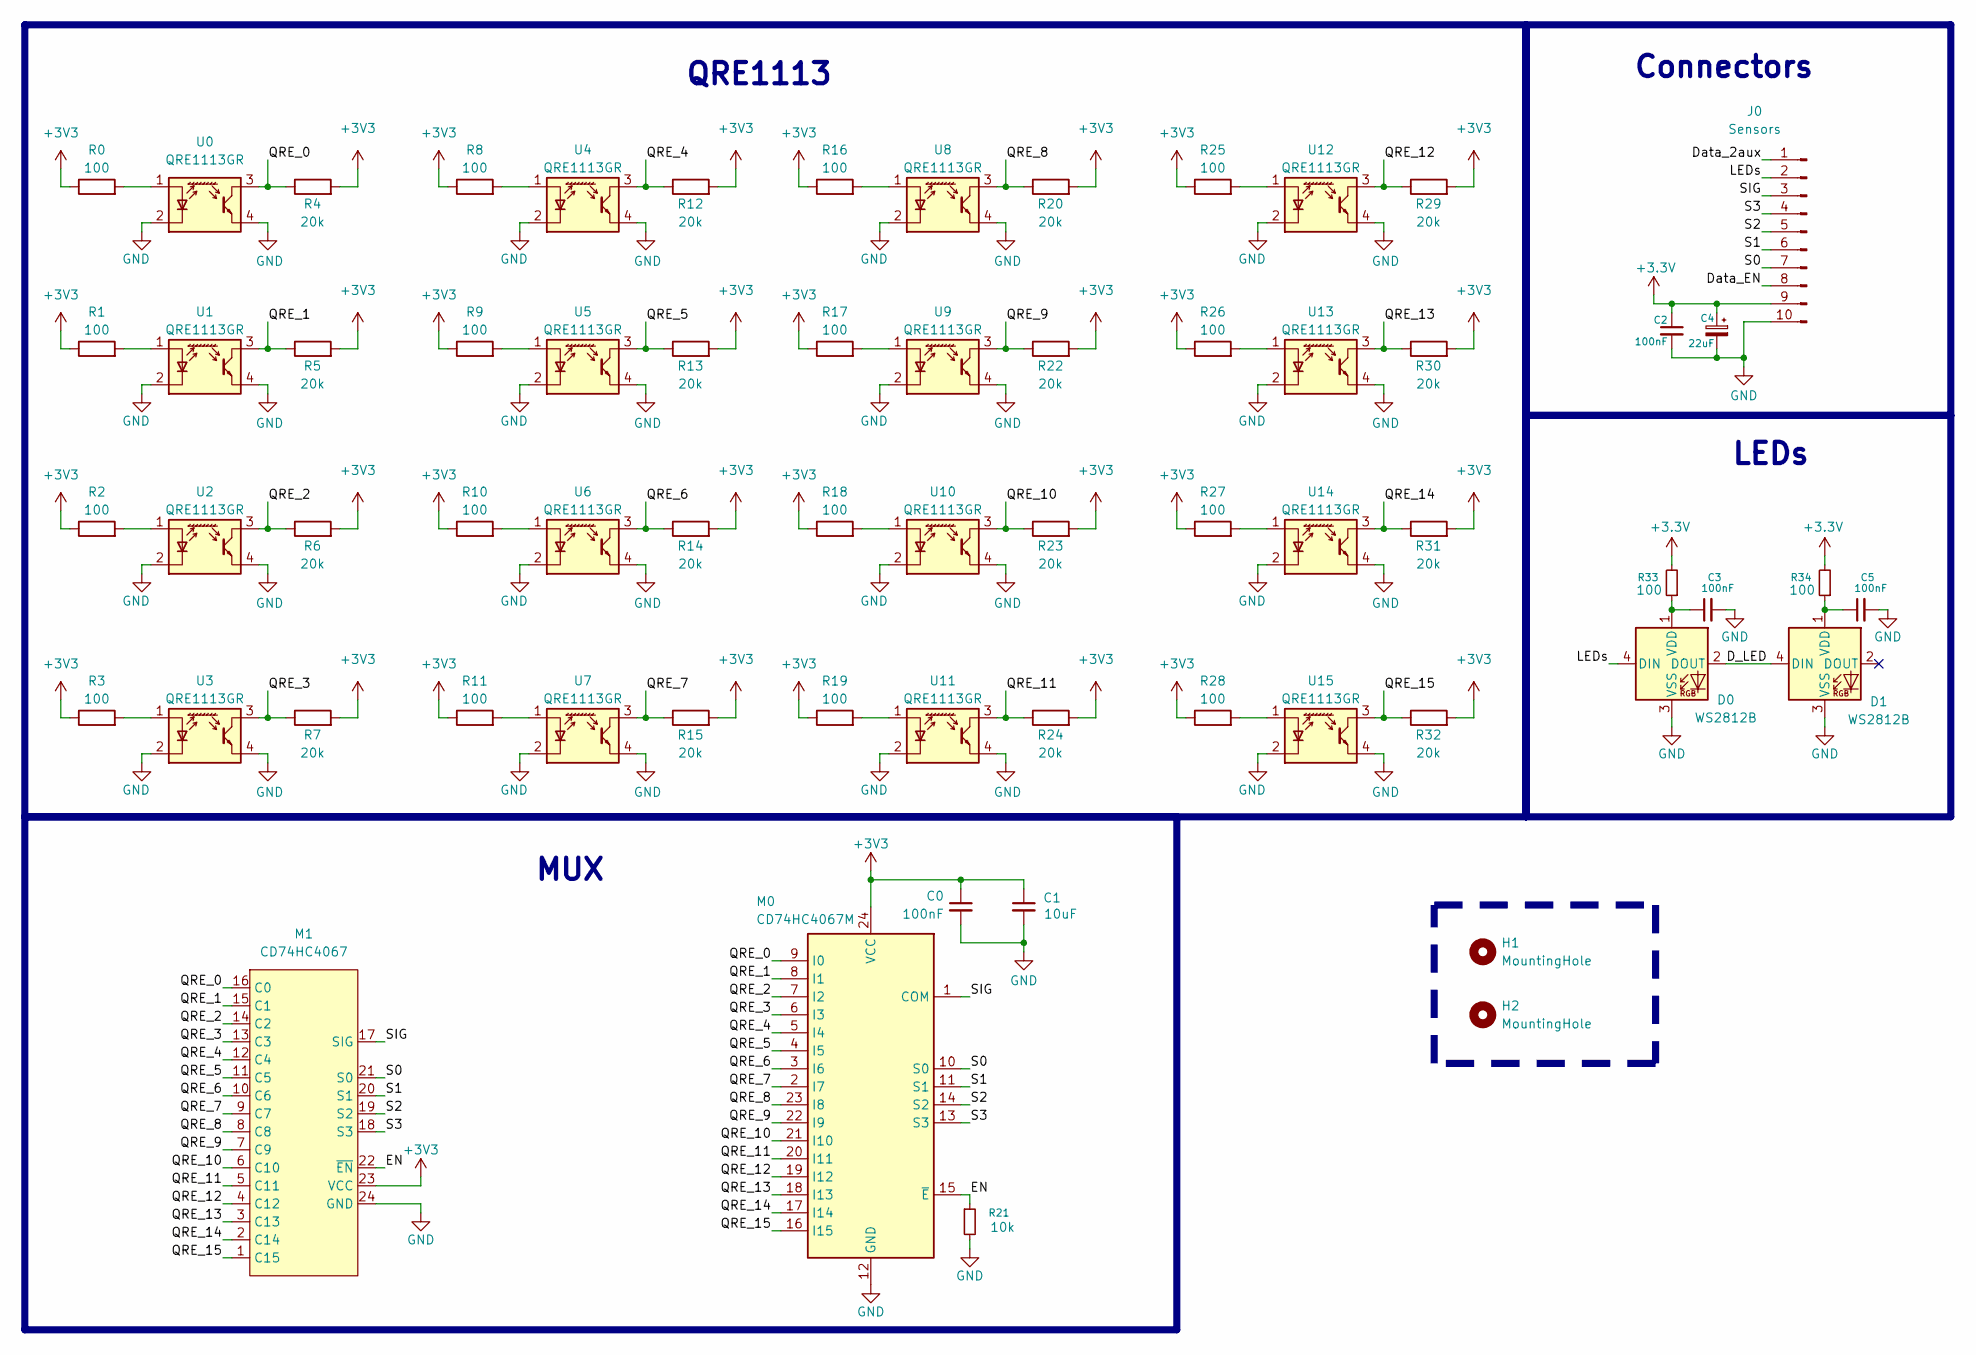
[picture p29: schematic sensors16_MagicAlonso.kicad_sch]

Parts:
C0, C2, C3, C5: 100nF; C_0805_2012Metric
C1: 10uF; C_0805_2012Metric
C4: 22uF; C_0805_2012Metric
D0, D1: WS2812B; LED_WS2812B_PLCC4_5.0x5.0mm_P3.2mm
H1, H2: MountingHole; MountingHole_3.2mm_M3_DIN965
J0: Sensors; JST_XH_S10B-XH-A_1x10_P2.50mm_Horizontal
M0: CD74HC4067M; SOIC-24W_7.5x15.4mm_P1.27mm
M1: CD74HC4067; CD74HC4067_module
R0, R1, R2, R3, R8, R9, R10, R11, R16, R17, R18, R19, R25, R26, R27, R28, R33, R34: 100; R_0805_2012Metric
R4, R5, R6, R7, R12, R13, R14, R15, R20, R22, R23, R24, R29, R30, R31, R32: 20k; R_0805_2012Metric
R21: 10k; R_0805_2012Metric
U0, U1, U2, U3, U4, U5, U6, U7, U8, U9, U10, U11, U12, U13, U14, U15: QRE1113GR; OnSemi_CASE100CY

Connections:
+3.3V: C2.1, C4.1, J0.9, R33.2, R34.2
+3V3: C0.1, C1.1, M0.24 (VCC), M1.23 (VCC), R0.1, R1.1, R2.1, R3.1, R4.2, R5.2, R6.2, R7.2, R8.1, R9.1, R10.1, R11.1, R12.2, R13.2, R14.2, R15.2, R16.1, R17.1, R18.1, R19.1, R20.2, R22.2, R23.2, R24.2, R25.1, R26.1, R27.1, R28.1, R29.2, R30.2, R31.2, R32.2
/D_LED: D0.2 (DOUT), D1.4 (DIN)
/Data_2aux: J0.1
/Data_EN: J0.8
/EN: M0.15 (~E), M1.22 (~EN), R21.1
/LEDs: D0.4 (DIN), J0.2
/QRE_0: M0.9 (I0), M1.16 (C0), R4.1, U0.3
/QRE_1: M0.8 (I1), M1.15 (C1), R5.1, U1.3
/QRE_2: M0.7 (I2), M1.14 (C2), R6.1, U2.3
/QRE_3: M0.6 (I3), M1.13 (C3), R7.1, U3.3
/QRE_4: M0.5 (I4), M1.12 (C4), R12.1, U4.3
/QRE_5: M0.4 (I5), M1.11 (C5), R13.1, U5.3
/QRE_6: M0.3 (I6), M1.10 (C6), R14.1, U6.3
/QRE_7: M0.2 (I7), M1.9 (C7), R15.1, U7.3
/QRE_8: M0.23 (I8), M1.8 (C8), R20.1, U8.3
/QRE_9: M0.22 (I9), M1.7 (C9), R22.1, U9.3
/QRE_10: M0.21 (I10), M1.6 (C10), R23.1, U10.3
/QRE_11: M0.20 (I11), M1.5 (C11), R24.1, U11.3
/QRE_12: M0.19 (I12), M1.4 (C12), R29.1, U12.3
/QRE_13: M0.18 (I13), M1.3 (C13), R30.1, U13.3
/QRE_14: M0.17 (I14), M1.2 (C14), R31.1, U14.3
/QRE_15: M0.16 (I15), M1.1 (C15), R32.1, U15.3
/S0: J0.7, M0.10 (S0), M1.21 (S0)
/S1: J0.6, M0.11 (S1), M1.20 (S1)
/S2: J0.5, M0.14 (S2), M1.19 (S2)
/S3: J0.4, M0.13 (S3), M1.18 (S3)
/SIG: J0.3, M0.1 (COM), M1.17 (SIG)
GND: C0.2, C1.2, C2.2, C3.2, C4.2, C5.2, D0.3 (VSS), D1.3 (VSS), J0.10, M0.12 (GND), M1.24 (GND), R21.2, U0.2 (K), U0.4, U1.2 (K), U1.4, U2.2 (K), U2.4, U3.2 (K), U3.4, U4.2 (K), U4.4, U5.2 (K), U5.4, U6.2 (K), U6.4, U7.2 (K), U7.4, U8.2 (K), U8.4, U9.2 (K), U9.4, U10.2 (K), U10.4, U11.2 (K), U11.4, U12.2 (K), U12.4, U13.2 (K), U13.4, U14.2 (K), U14.4, U15.2 (K), U15.4
unnamed: C3.1, D0.1 (VDD), R33.1
unnamed: C5.1, D1.1 (VDD), R34.1
unnamed: R0.2, U0.1 (A)
unnamed: R1.2, U1.1 (A)
unnamed: R2.2, U2.1 (A)
unnamed: R3.2, U3.1 (A)
unnamed: R8.2, U4.1 (A)
unnamed: R9.2, U5.1 (A)
unnamed: R10.2, U6.1 (A)
unnamed: R11.2, U7.1 (A)
unnamed: R16.2, U8.1 (A)
unnamed: R17.2, U9.1 (A)
unnamed: R18.2, U10.1 (A)
unnamed: R19.2, U11.1 (A)
unnamed: R25.2, U12.1 (A)
unnamed: R26.2, U13.1 (A)
unnamed: R27.2, U14.1 (A)
unnamed: R28.2, U15.1 (A)

Notes on the sheet:
Connectors
LEDs
MUX
QRE1113

Board: 2 copper layers, 64 parts (18 on the bottom side), 45 nets, no tracks yet.
