JRegi/MagicAlonso-LineFollower/(commit log)

2024-11-19 Adding libraries and main code
    Added a premature version of led controlling and array reading libraries as well with the base files for the main code.
2024-12-02 Including basic main code and fixing a privacy problem in sensor_array.h
    [main.cpp]
2025-04-04 2.9 to 1 transmission 3d files
    [33x20mm Wheel 35t gear.step, Motor Mount.step, Motor gear 12t.step, Wheel Mount.step]
2025-06-02 Kicad pcb intial drawing
    [kicad_pro MagicAlonso.kicad_pcb, kicad_pro MagicAlonso.kicad_sch]
2025-06-03 updated transmission module
    [23.5 Wheel 28 teeth v14.stl, 33x20mm Wheel 35t gear.step, Motor Mount.step, Motor Mount.stl, Motor gear 12t.step, Wheel Mount.step, Wheel Mount.stl, pignon 12t 0.7 short.stl]
2025-06-05 pcb schematic update
    [kicad_pro MagicAlonso.kicad_sch, main_MagicAlonso.kicad_pcb, main_MagicAlonso.kicad_sch]
2025-06-06 Schematic & PCB updates
    made advancements on the schematic circuits and the PCB layout drawings.
    [main_MagicAlonso.kicad_pcb, main_MagicAlonso.kicad_sch]
2025-06-08 more schematic stuff
    Added ch340 and some more stuff
    [CH340G_programmer.kicad_sch, main_MagicAlonso.kicad_sch]
2025-06-09 more schematic
    [CH340G_programmer.kicad_sch, main_MagicAlonso.kicad_sch]
2025-06-09 yes, schematic
    [main_MagicAlonso.kicad_sch]
2025-06-10 hehe schematic go brr
    [main_MagicAlonso.kicad_sch]
2025-06-10 schematic go fiuuu
    [main_MagicAlonso.kicad_sch]
2025-06-14 StepDown schematic sub-file
    MP2315GJ circuit sub-file added.
    [StepDown_2315.kicad_sch, main_MagicAlonso.kicad_sch]
2025-06-14 schematic and test commit
    [CH340G_programmer.kicad_sch, StepDown_2315.kicad_sch, main_MagicAlonso.kicad_sch]
2025-06-16 Big changes PCB
    Advancements on the schematic were made:
    - Completed MP2315 circuit
    - Passive Buzzer
    - Mounting holes & other symbols added
    Also the PCB drawings were improved.
    [33x20mm Wheel 35t gear.step, Assembly 23.5mm ver Drawing v2 Sheet1.dxf, BaseProjection_redo_mod_23.5.dxf, CH340G_programmer.kicad_sch, Motor Mount.step, Motor gear 12t.step, StepDown_2315.kicad_sch, Wheel Mount.step]
2025-06-17 Schematic and PCB
    [main_MagicAlonso.kicad_pcb, main_MagicAlonso.kicad_sch]
2025-06-17 schematic and pcb drawings
    [Assembly 23.5mm ver Drawing v2 Sheet1.dxf, BaseProjection_red_23.5mm.dxf, BaseProjection_redo_mod_23.5.dxf, main_MagicAlonso.kicad_pcb, main_MagicAlonso.kicad_sch]
2025-06-18 schematic updates
    [main_MagicAlonso.kicad_pcb, main_MagicAlonso.kicad_sch]
2025-06-19 schematic almost finished
    [CH340G_programmer.kicad_sch, StepDown_2315.kicad_sch, main_MagicAlonso.kicad_pcb, main_MagicAlonso.kicad_sch]
2025-06-20 some footprint assignment
    [CH340G_programmer.kicad_sch, StepDown_2315.kicad_sch, main_MagicAlonso.kicad_sch]
2025-06-21 footprint assingment completed
    [CH340G_programmer.kicad_sch, StepDown_2315.kicad_sch, main_MagicAlonso.kicad_sch]
2025-06-21 pcb footprint added
    [CH340G_programmer.kicad_sch, main_MagicAlonso.kicad_pcb, main_MagicAlonso.kicad_sch]
2025-06-23 pcb components & label fixes
    [CH340G_programmer.kicad_sch, StepDown_2315.kicad_sch, main_MagicAlonso.kicad_pcb, main_MagicAlonso.kicad_sch]
2025-06-24 yes, pcb
    [StepDown_2315.kicad_sch, main_MagicAlonso.kicad_pcb, main_MagicAlonso.kicad_sch]
2025-06-24 more pcb stuff ha
    [CH340G_programmer.kicad_sch, StepDown_2315.kicad_sch, main_MagicAlonso.kicad_pcb, main_MagicAlonso.kicad_sch]
2025-06-25 pcb pcb
    [CH340G_programmer.kicad_sch, main_MagicAlonso.kicad_pcb, main_MagicAlonso.kicad_sch]
2025-06-25 pcb sync
    [CH340G_programmer.kicad_sch, main_MagicAlonso.kicad_pcb, main_MagicAlonso.kicad_sch]
2025-06-28 pcb changes
    [main_MagicAlonso.kicad_pcb, main_MagicAlonso.kicad_sch]
2025-06-29 PCB components order
    [CH340G_programmer.kicad_sch, main_MagicAlonso.kicad_pcb, main_MagicAlonso.kicad_sch, turbine_PCB_Drawing.dxf]
2025-06-30 PCB advancements
    [StepDown_2315.kicad_sch, main_MagicAlonso.kicad_pcb, main_MagicAlonso.kicad_sch]
2025-07-01 mais avances en la pcb
    [main_MagicAlonso.kicad_pcb, main_MagicAlonso.kicad_sch]
2025-07-01 Update PCB
    [main_MagicAlonso.kicad_pcb]
2025-07-06 first PCB layout done
    [main_MagicAlonso.kicad_pcb, main_MagicAlonso.kicad_sch]
2025-07-08 sensors pcb added
    [main_MagicAlonso-rounded.kicad_pcb, main_MagicAlonso.kicad_pcb, sensors16_MagicAlonso.kicad_pcb, sensors16_MagicAlonso.kicad_sch]
2025-07-08 sensors pcb update
    [main_MagicAlonso.kicad_sch, sensors16_MagicAlonso.kicad_sch]
2025-07-09 pcb update
    [main_MagicAlonso.kicad_pcb, main_MagicAlonso.kicad_sch, sensors16_MagicAlonso.kicad_sch]
2025-07-10 test project
    [CH340G_programmer.kicad_sch, StepDown_3903.kicad_sch, main_MagicAlonso-rounded.kicad_pcb, main_MagicAlonso__test.kicad_pcb, main_MagicAlonso__test.kicad_sch]
2025-07-12 sensors16 pcb update
    [sensors16_MagicAlonso.kicad_pcb, sensors16_MagicAlonso.kicad_sch]
2025-07-22 Updated Motor_Mount 3d file
    [1.Redo2.stp, 2.Redo2.9to1+23.stp, 23.stp, Molde+23.stp, Motor Mount.stl, Motor_mount.stl, pignon+12t+0.stp, reduction.FCStd]
2025-07-30 simple main board added and donde
    [CH340G_programmer.kicad_sch, StepDown_2315.kicad_sch, main_Magic-simple.kicad_pcb, main_Magic-simple.kicad_sch, main_Magic-simple_printable.kicad_pcb]
2025-08-06 Added main pcb image
2025-08-07 set simple pcb project as read-only
2025-08-07 line sensors body
    [Line_Sensors-Body.stl, Line_Sensors.FCStd]
2025-08-13 STM32 pcb created
    [CH340G_programmer.kicad_sch, StepDown_2315.kicad_sch, main_Magic-simple.kicad_pcb, main_Magic-simple.kicad_sch, main_Magic-simple_printable.kicad_pcb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]
2025-08-13 stm32 pcb schematic update
    [main_Magic_BluePIll.kicad_sch]
2025-08-15 bluepill pcb
    [main_Magic_BluePIll.kicad_pcb, main_Magic_BluePIll.kicad_sch]
2025-08-17 components arranged in bluepill pcb
    [main_Magic_BluePIll.kicad_pcb, main_Magic_BluePIll.kicad_sch]
2025-08-18 Routing of STM32F103 PCB done
    [Turbine_PCB_3P_Drawing.dxf, main_Magic_BluePIll.kicad_pcb, main_Magic_BluePIll.kicad_sch]
2025-08-18 RGB led added to STM32 pcb
    [main_Magic_BluePIll.kicad_pcb, main_Magic_BluePIll.kicad_sch]
2025-08-18 printable_pcb added
    [printable_PCB.kicad_pcb, printable_PCB.kicad_sch]
2025-08-19 Minor pcb changes
    [printable_PCB.kicad_pcb]
2025-08-22 BluePill board archived
2025-08-27 test de leds en main.c
    [main_Magic_BluePIll.kicad_pcb]
2025-08-29 test de motores
    [main_Magic_BluePIll.kicad_pcb, main_Magic_BluePIll.kicad_sch, printable_PCB.kicad_pcb, printable_PCB.kicad_sch]
2025-08-31 reordered stl files
    [23.5 Wheel 28 teeth v14.stl, Line_Sensors-Body.stl, Line_Sensors.FCStd, Motor_mount.stl, Wheel Mount.stl, modulo_redu_V3.stl, pignon 12t 0.7 short.stl]
2025-08-31 PWM motor test
2025-09-01 reduccion V3 y rueda 26mm
    [Spur Gear (15 teeth).stl, modulo_redu_V3.stl, wheel_32teeth_26mm.stl]
2025-09-01 actualizacion Puente_V3
    [Puente_V3.stl]
2025-09-07 Añadiendo libreria para el moduilo hc05
2025-09-07 Probando la lectura de sensores
    Se creó una nueva librería para la lectura de la regleta y se preparó un main para probar su funcionamiento mediante la devolución bluetooth de la posición.
2025-09-07 Deshaciendose de operaciones con coma flotante
2025-09-08 Simpplificando la librería de control de ESCs
2025-09-09 DXF para reduccion 1404
    [1404_redu_footprint.dxf, BaseProjection_red_23.5mm.dxf]
2025-09-10 Nueva libreria de QRE aun más simple
2025-09-10 Añadiendo funcion de linea negra y linea blanca
2025-09-10 Añadiendo funcion para leer canales individuales crudos
2025-09-10 Añadiendo calibracion y armado a la libreria esc
2025-09-10 Arreglos menores
    El parametro q de la funcion adc_set_regular_sequence ahora se convierte a uint8_t para que no salte un warning
2025-09-10 invirtiendo funciones de color de linea
2025-09-10 arreglando la libreria qre_array
2025-09-11 Revert "otra vez"
    This reverts commit 1d58dda6d77afcfcf9c19ff143ab5fd3a12077ab.
    [main.c]
2025-09-11 Revert "arreglando la libreria qre_array"
    This reverts commit 10b3f97ac38eee443c69caae07baf9dcedc46cb5.
2025-09-11 Revert "añadiendo scan mode y promedio a qre_array"
    This reverts commit 6eb4212f3370c194c844f441af7f3057af2f04e1.
    [main.c]
2025-09-11 Implementando PID básico
2025-09-11 Intento de arreglar calibracion de ESC
    [main.c]
2025-09-12 Añadiendo libreria para comunicacion uart
2025-09-12 Añadiendo umbrales y funcion de perdida de linea
2025-09-12 buttons & rgb setup and basic functions
2025-09-12 Revert "no anda :) se queda bloqueado en calibracion"
    This reverts commit 21bfcf9e1fdc6ba3f80ea4397a01b35184c8c22c.
    [main.c]
2025-09-12 Revert "buttons & rgb setup and basic functions"
    This reverts commit 612e09d623bfe37c0d35b974dc8abad284af33e1.
    [main.c]
2025-09-12 Revert "Añadiendo umbrales y funcion de perdida de linea"
    This reverts commit 87b926e43c02d9452ca1bf7a14947c152ae40c60.
2025-09-16 PD calibration
2025-10-03 Revert "aniadiendo libreria receptor ir"
    This reverts commit a8d4d85dfe0b0c7f4325f52ef97438d16eb6c6aa.
    [main.c]
2025-11-12 PID calibration & broken menu
    [main_Magic_BluePIll.kicad_sch]
